OrsoEric/OrangeHat/README.md

# OrangeHat
Raspberry Pi Hat

**TPS55386 Board**  
Dual buck from 2S to 4S LIPO to two 3.0A channels.  
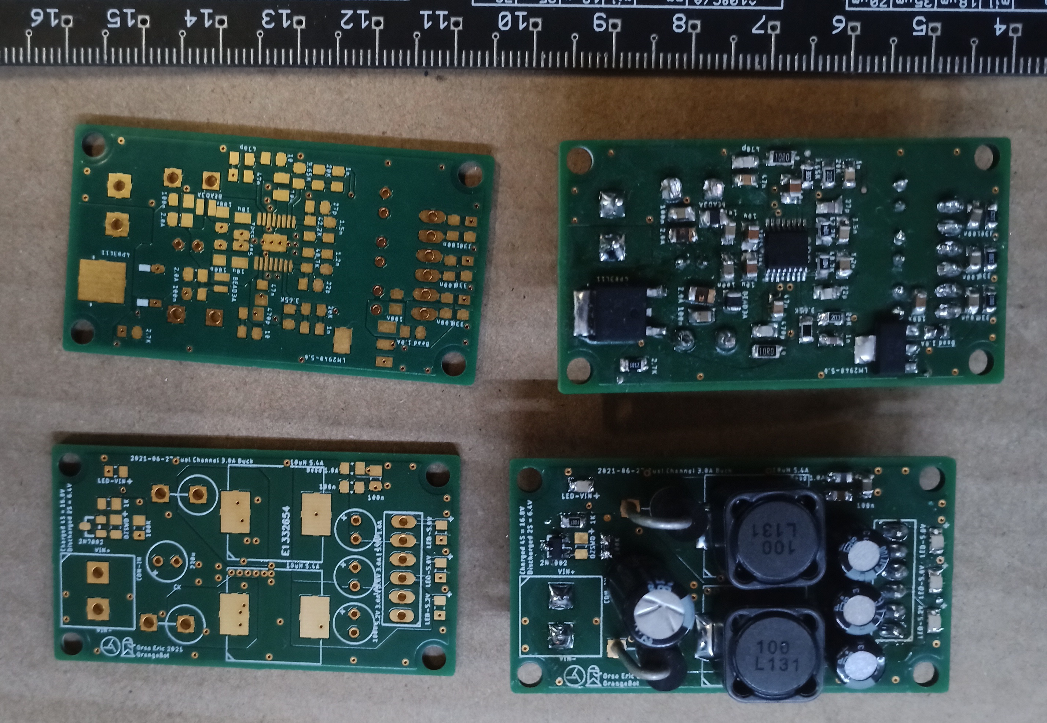
[picture p1: Hardware/Board-Regulator/2021-08-05 TPS55386 Board.jpg]
  

**OrangeHat**  
Assembly
  
  
Demo OrangeHat installed on Maze Runner (click on image to see video on youtube)    
Maze Runner OrangeHat (https://youtu.be/MLvYplDcF7E)  

**OrangeHat Firmware**  
LCD Display (click on image to see video on youtube)  
LCD Display (https://youtu.be/4nYxutRMj2Q)  

Eight Servomotors Demo

https://github.com/user-attachments/assets/cbe1ea65-5b8f-492d-bec4-1e71fcff2395

Eight Servomotor Demo (https://youtu.be/TLqbNKa-QK0)  

**OrangeHat Software**  
NODE.JS Webserver video streaming and serial communication (click on image to see video on youtube)  
NODE.JS (https://youtu.be/cQ1488kovP8)
