OrsoEric/OrangeHat/Software/readme.txt

OrangeHat software running inside the Raspberry Pi
