OrsoEric/OrangeHat/Hardware/Board-Regulator/Readme.md

# Board Regulator Schamatics    
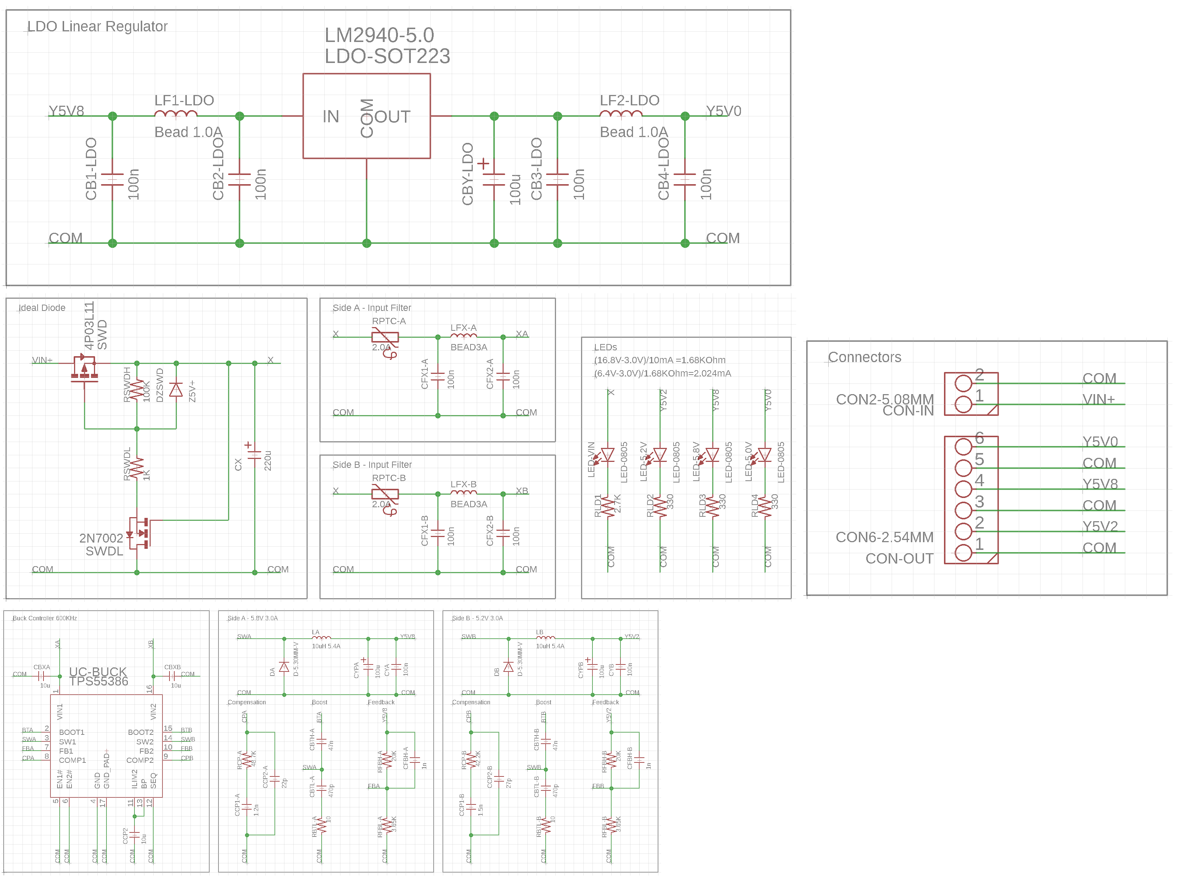
[picture p7: Hardware/Board-Regulator/2021-07-03 Board Voltage Regulator Schematics.PNG]
Board-Regulator
    
  
# Board Regulator PCB  
Output 1: 5.8V 3.0A  
Output 2: 5.2V 3.0A  
Output 3: 5.0V 1.0A  
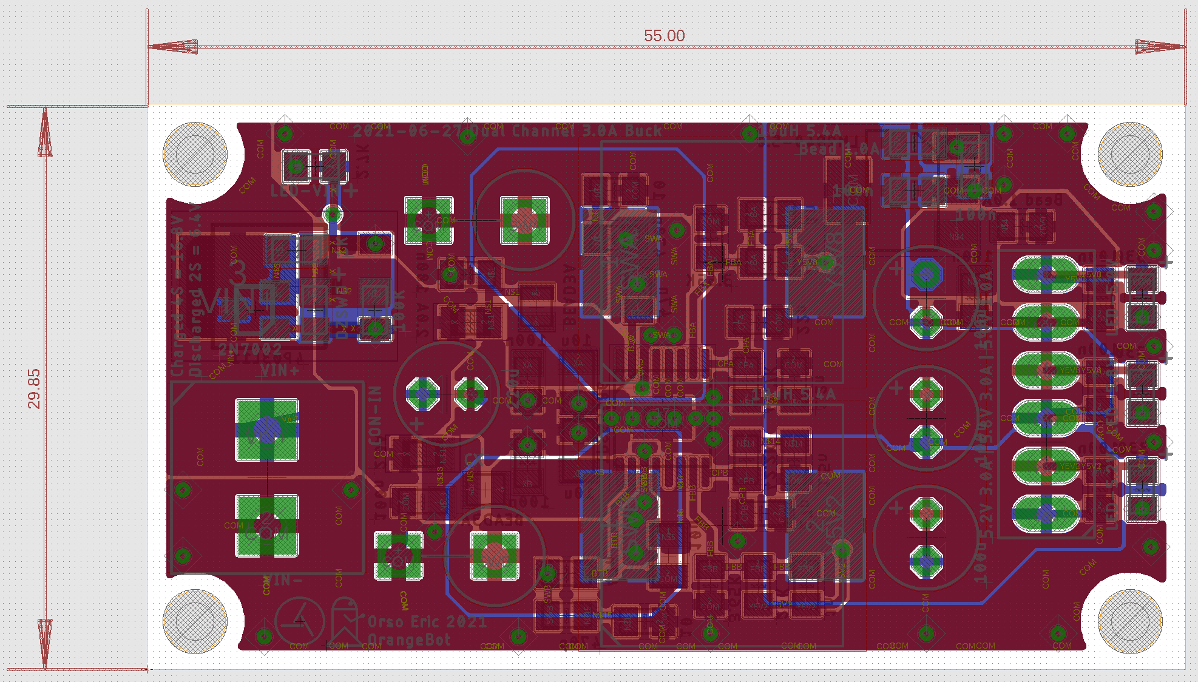
[picture p8: Hardware/2021-07-03 Board Voltage Regulator.PNG]
Board-Regulator
  

Render:
Regulator PCB render:  
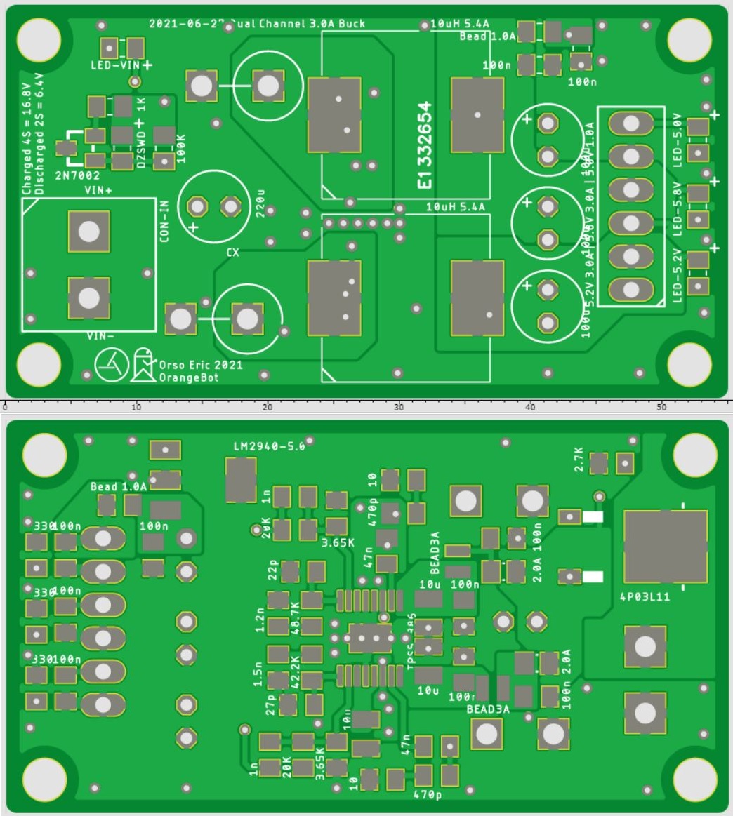
[picture p9: Hardware/Board-Regulator/2021-06-27 Regulator PCB.JPG]
Board PCB Render


**Assembled Board**  
