OrsoEric/OrangeHat/Hardware/OrangeHat/readme.md

**FEATURES**  
- XT60 power connector
- TPS55386 Dual Buck two 5.2V3.0A channels. Reverse voltage protection. Passive and active overcurrent protection.
- Full power monitor. Three voltages, Three currents.
- Raspberry Pi GPIO (10pins) UART and RESET (for bootloader)
- AT4809 microcontroller with UPDI programming
- One user button. Two user LEDs-
- 16x2 LCD screen
- RS485 commuinication over 3.5mm Jack audio cables.
- 8x Servo channels
- Onboard Waveshare 10DOF IMU

**Schematics**  
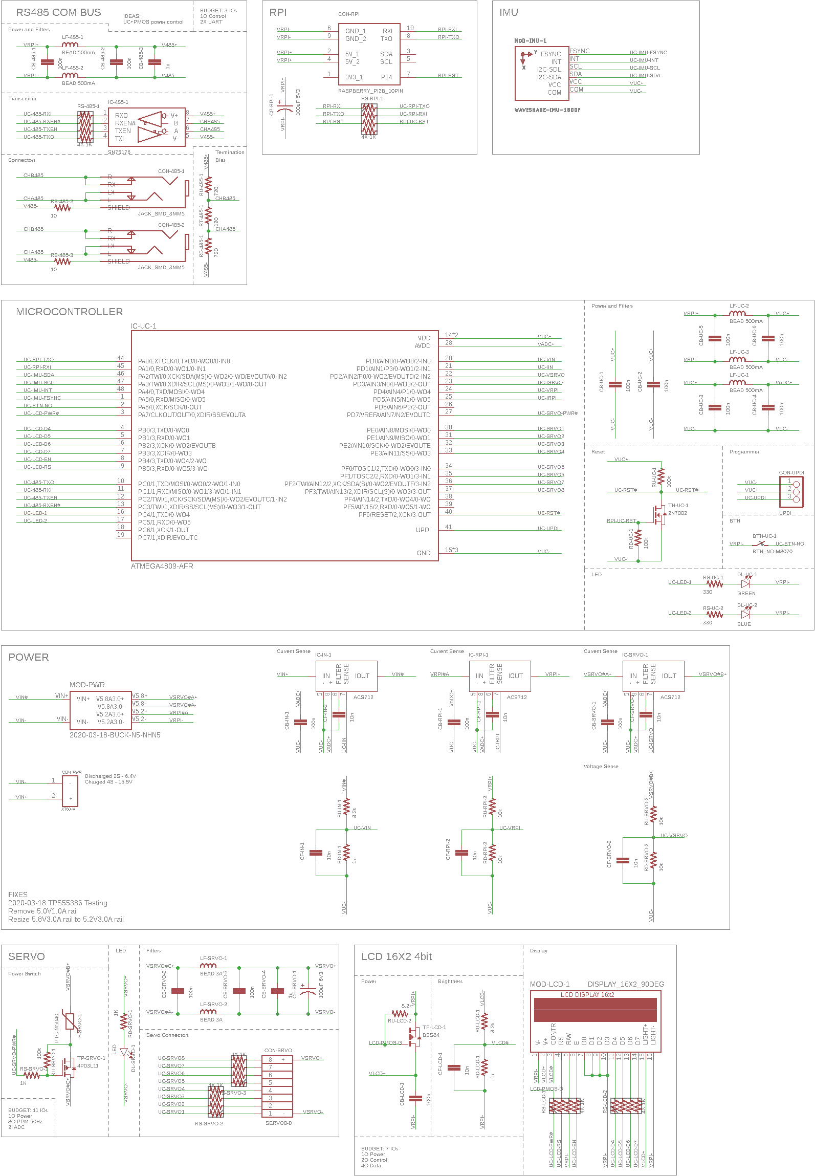
[picture p10: Hardware/OrangeHat/Media/2021-08-11 OrangeHat Schematics.png]
  

**PCB Render**  
Render of PCB, Top and Bot side.  
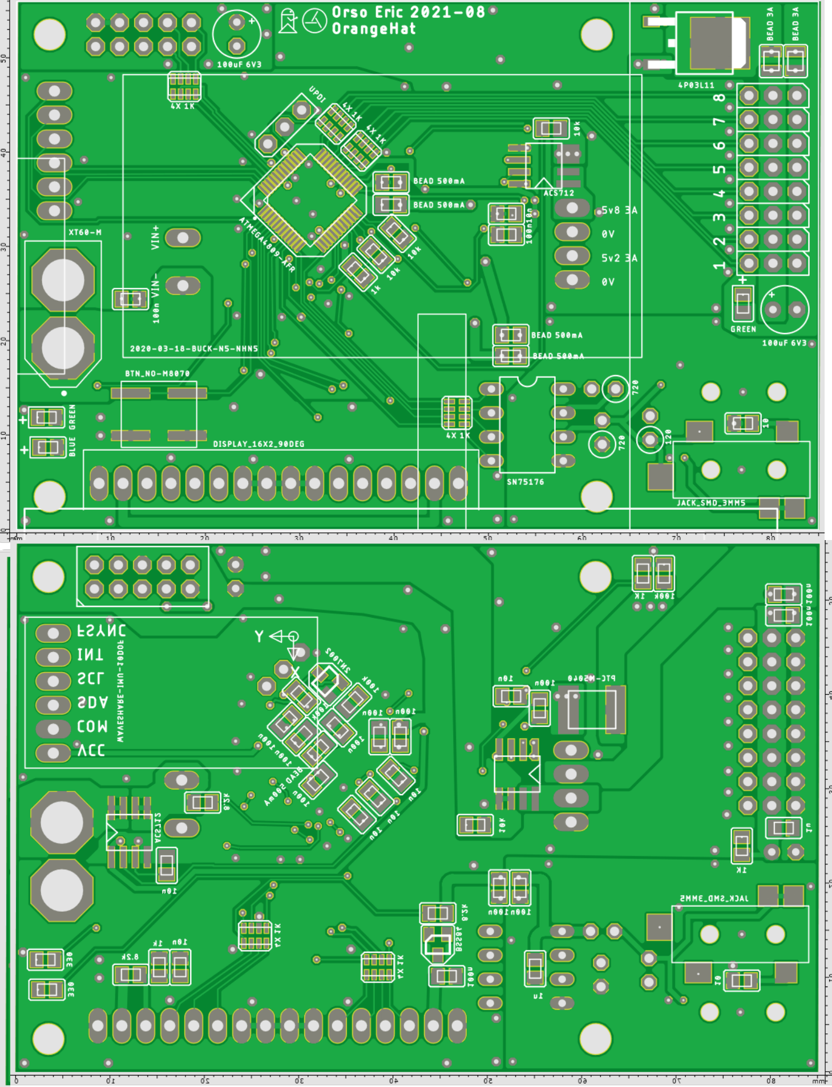
[picture p11: Hardware/OrangeHat/Media/2021-08-11 OrangeHat PCB.PNG]
PCB
  
Render of the gerbers files.  
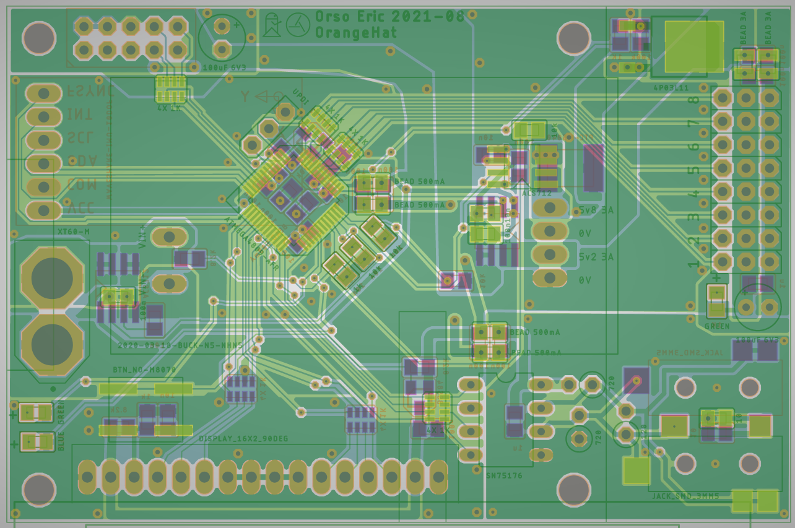
[picture p12: Hardware/OrangeHat/Media/2021-08-11 OrangeHat Gerber.png]
Gerber
  

**Microcontroller Pin Assignment Table**  
