OrsoEric/OrangeHat/Hardware/OrangeHat/Media/2021-07-24 OrangeHat RS485.PNG

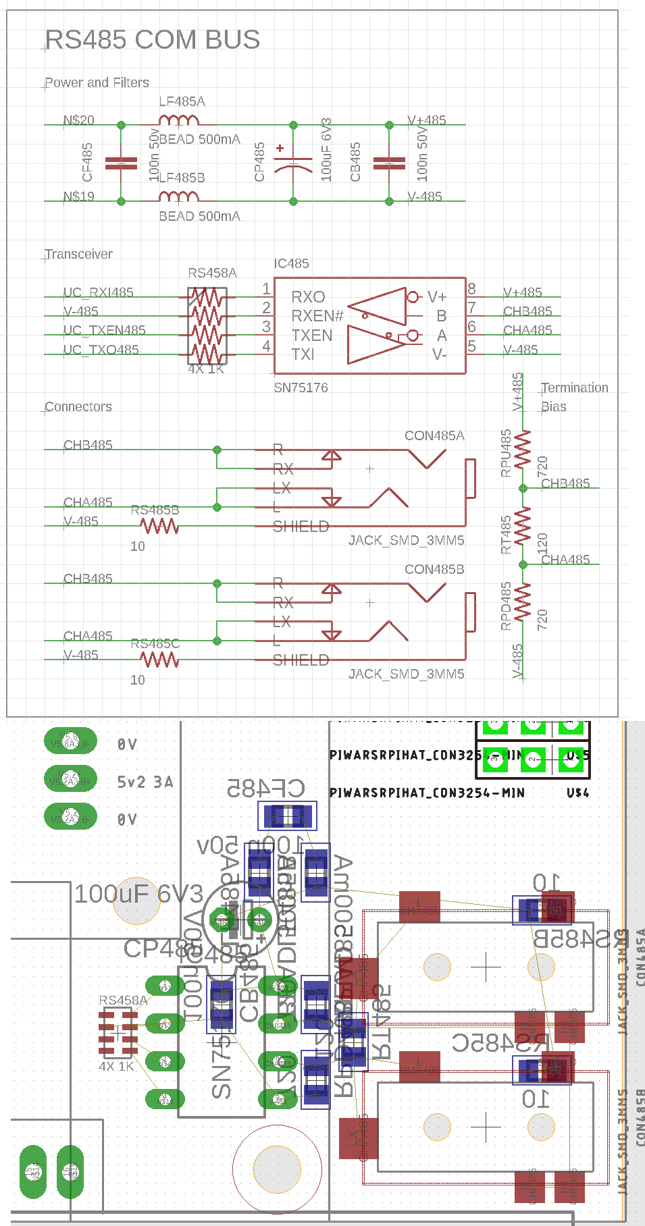
Hardware/OrangeHat/Media/2021-07-24 OrangeHat RS485.PNG
