OrsoEric/OrangeHat/Hardware/OrangeHat/Media/2021-07-25 LCD Placement.PNG

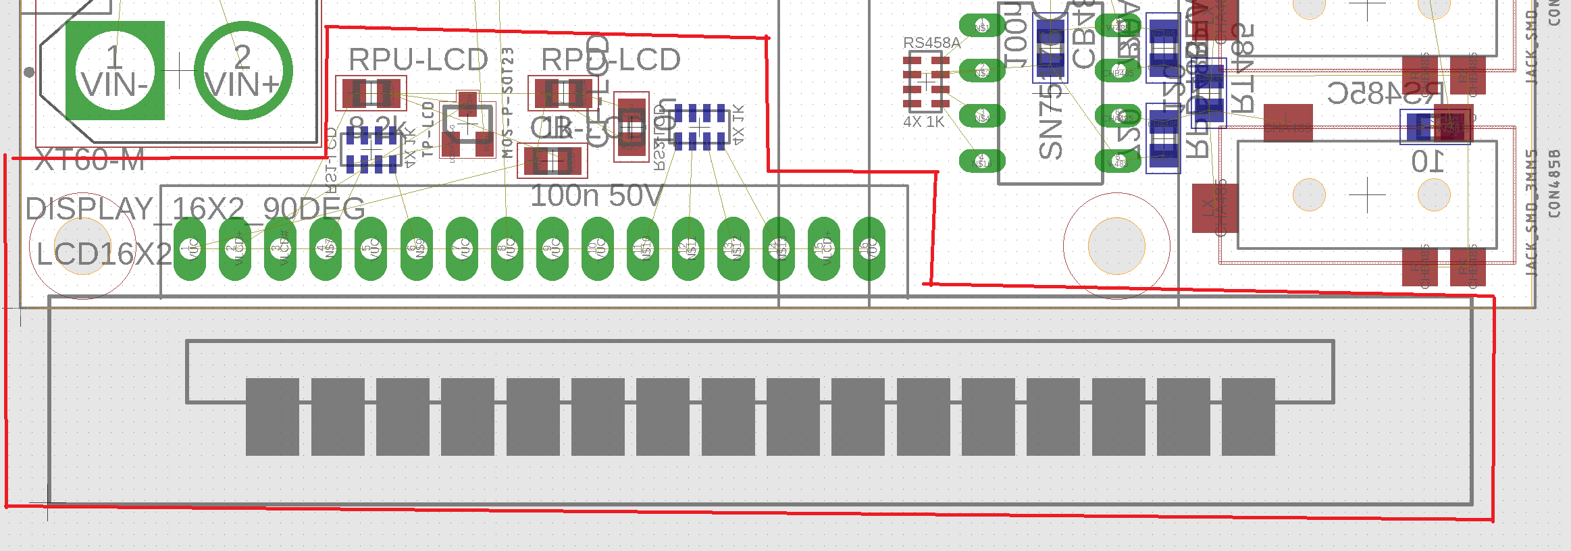
Hardware/OrangeHat/Media/2021-07-25 LCD Placement.PNG
