OrsoEric/OrangeHat/Hardware/OrangeHat/Media/2021-07-25 LCD Schematics.PNG

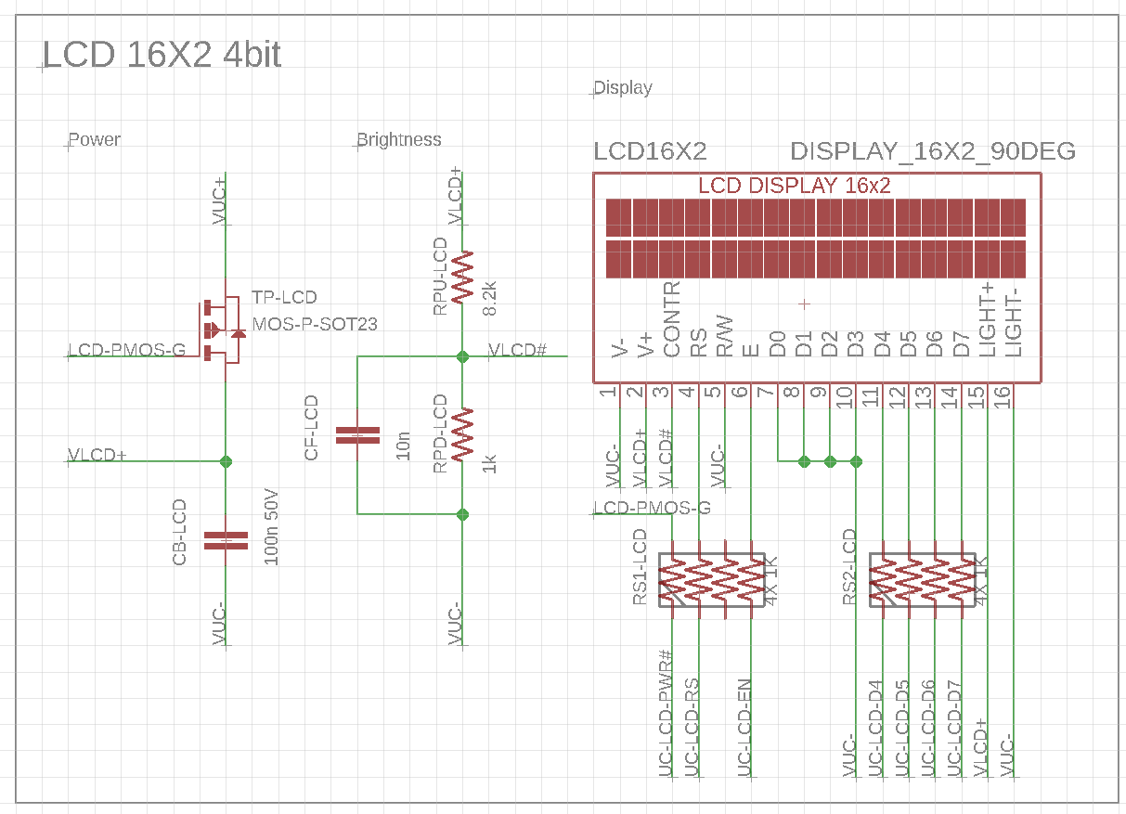
Hardware/OrangeHat/Media/2021-07-25 LCD Schematics.PNG
