OrsoEric/OrangeHat/Hardware/OrangeHat/Media/2021-07-25 OrangeHat LCD Mockup.jpg

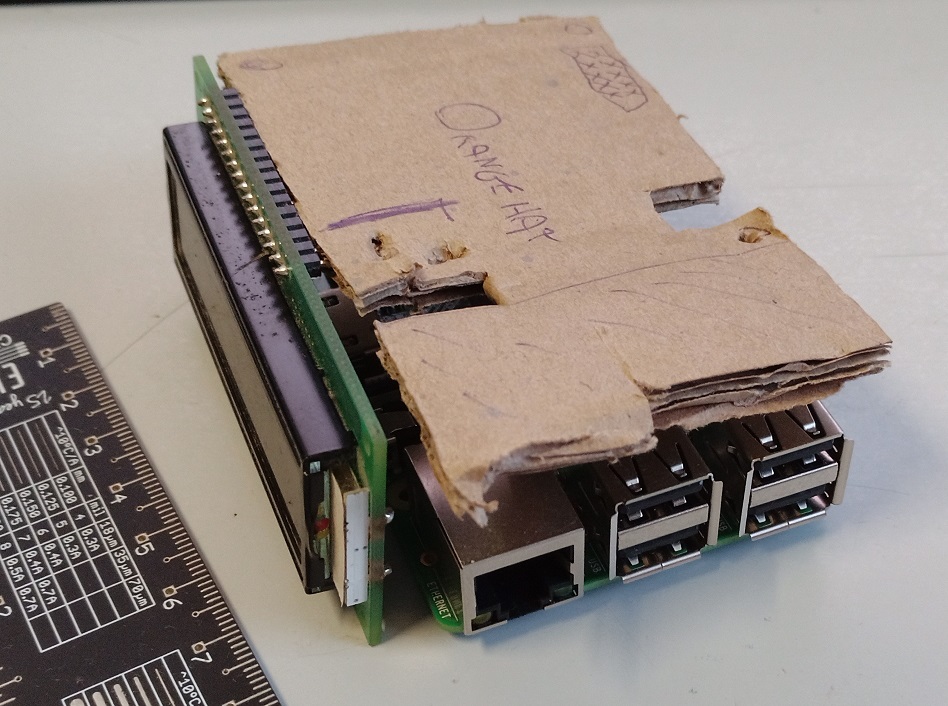
Hardware/OrangeHat/Media/2021-07-25 OrangeHat LCD Mockup.jpg
