OrsoEric/OrangeHat/Hardware/OrangeHat/Media/2021-07-25b OrangeHat Servo Placement.PNG

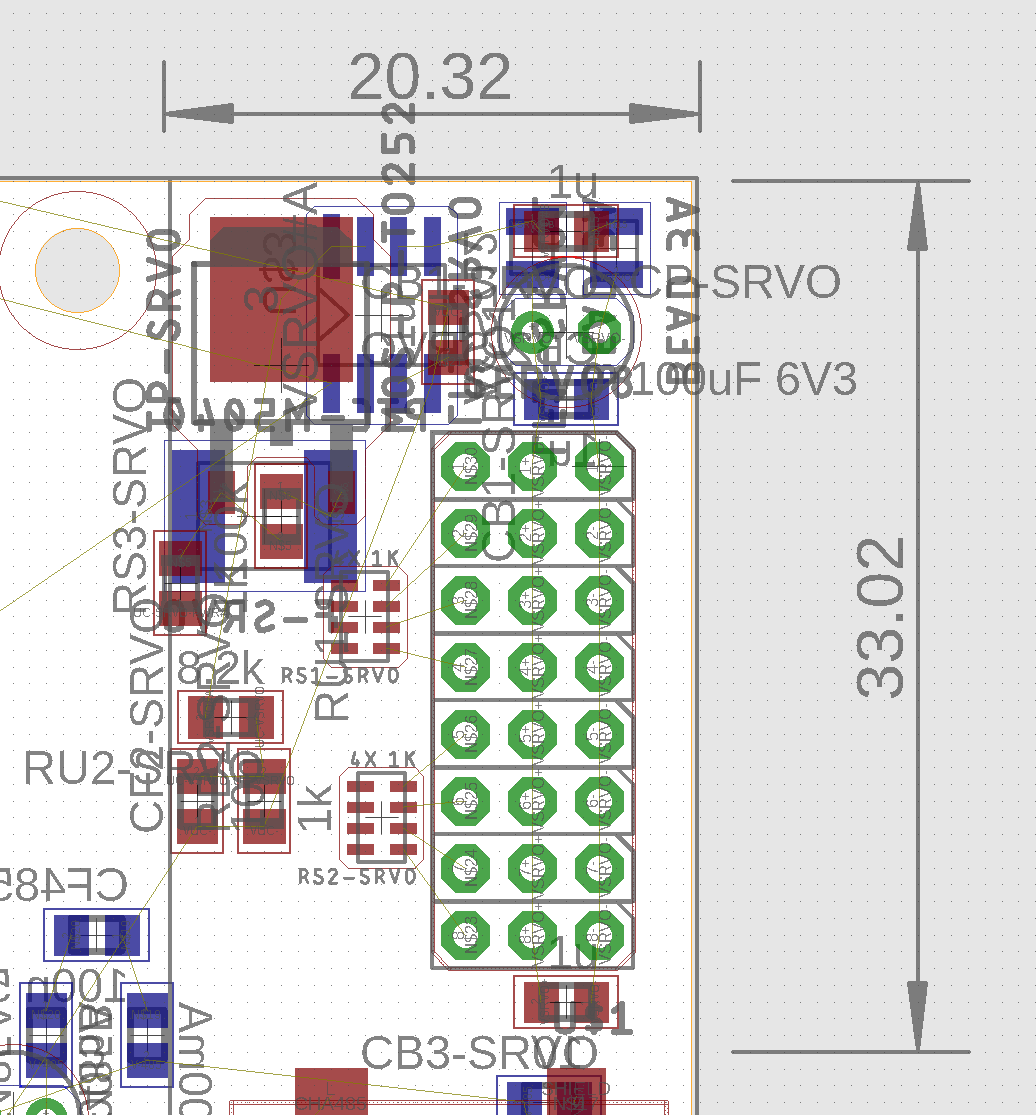
Hardware/OrangeHat/Media/2021-07-25b OrangeHat Servo Placement.PNG
