OrsoEric/OrangeHat/Hardware/OrangeHat/Media/2021-07-25b OrangeHat Servo Schematics.PNG

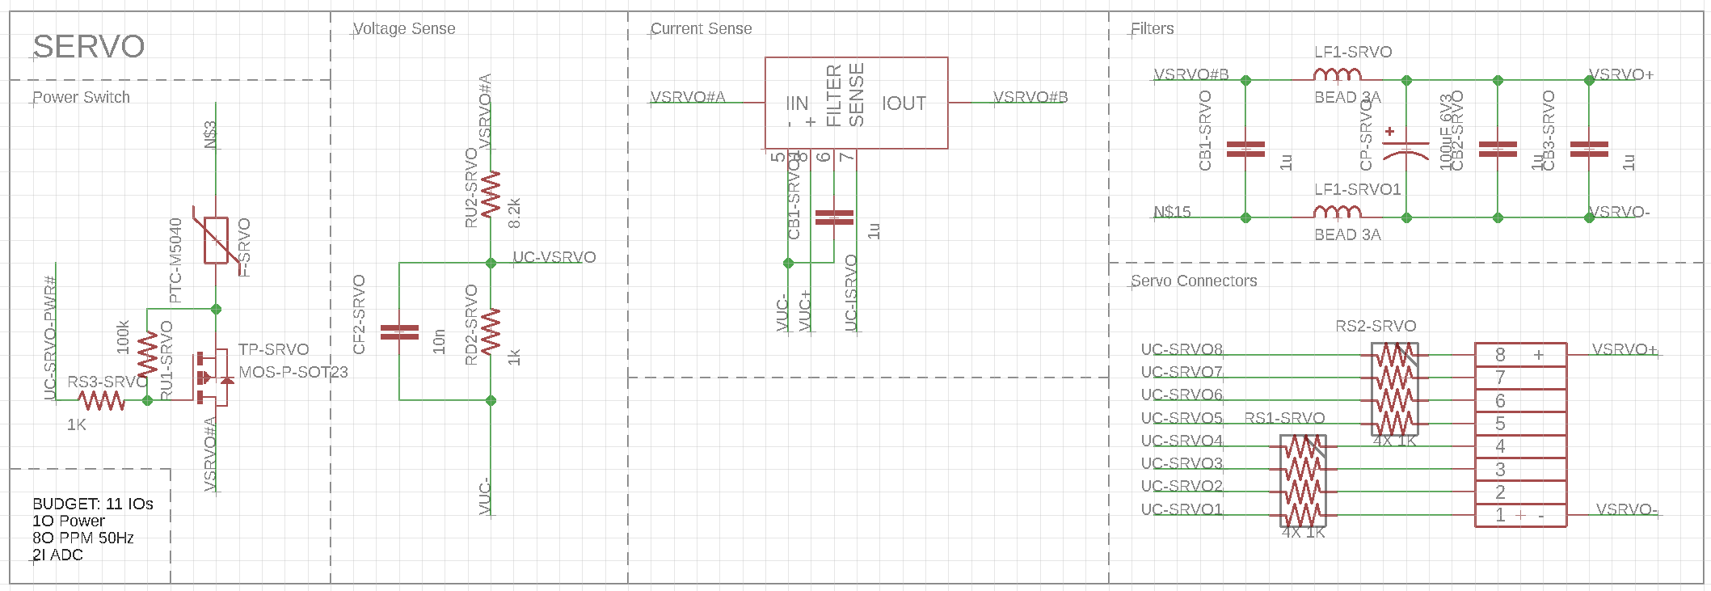
Hardware/OrangeHat/Media/2021-07-25b OrangeHat Servo Schematics.PNG
