OrsoEric/OrangeHat/Hardware/OrangeHat/Media/2021-08-10c autoroute success.PNG

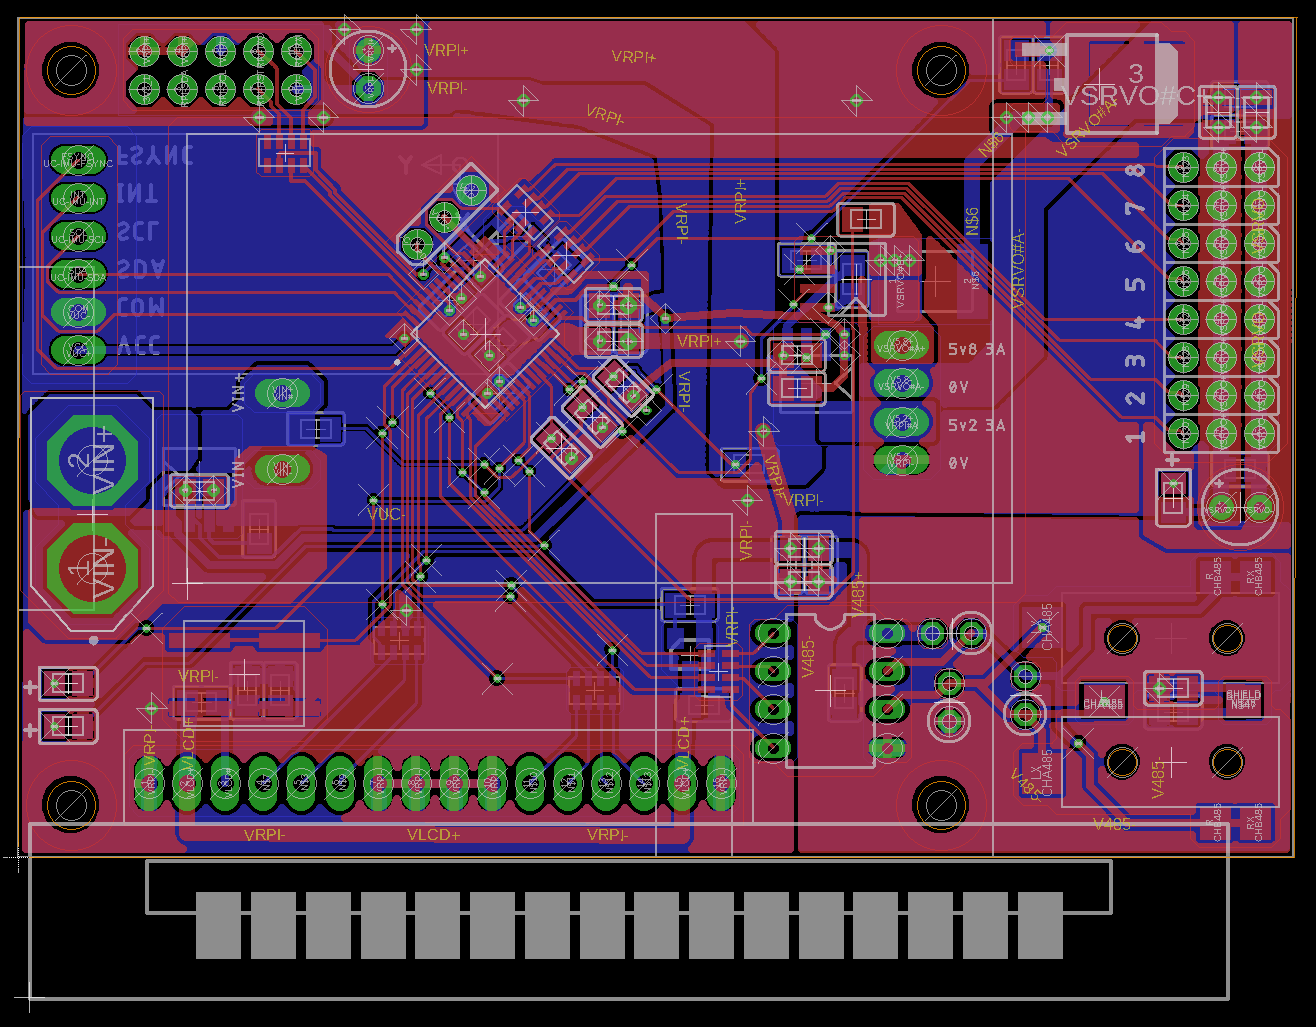
Hardware/OrangeHat/Media/2021-08-10c autoroute success.PNG
