OrsoEric/OrangeHat/Hardware/Board-Regulator/2021-08-05 TPS55386 No Load Test.jpg

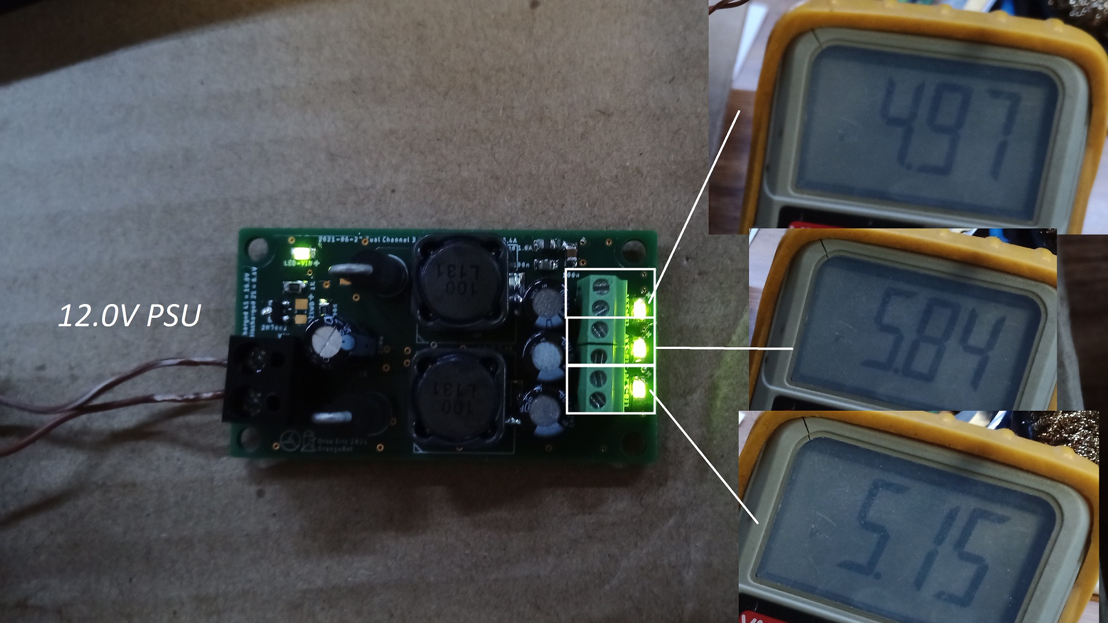
Hardware/Board-Regulator/2021-08-05 TPS55386 No Load Test.jpg
