OrsoEric/OrangeHat/(threads)

Thread 3 (2021-06-27):

OrangeHat Architecture - Microcontroller

OrsoEric, 2021-06-27:
Choose OrangeHat microcontroller
#1 Epic

OrsoEric, 2021-07-04:
Microcontrollers
1. AT4809 8b20MHz
2. GD32VF103 32b108MHz

The Risc-V uC has a good evaluation board with a good screen and is more powerful. The MIPS are needed to run multimotor PIDs. By design decision, this Hat will not integrate the DC H-Bridges, the AT microcontroller is good enough.

Closed 2021-07-04.

Thread 4 (2021-07-03):

Board Regulator

OrsoEric, 2021-07-03:
OrangeBot demonstrated that the dual buck TPS55386 can successfully powewr the raspberry, few servos and the main board.
The regulator is to be moved to its own PCB in a more compact module.
- [x] Schematics
- [x] Routing
- [x] BOM and Order Components
- [x] Print PCBs
- [x] Assembly
- [x] Testing #14
- [ ] Problems 2021-08 #15
- [ ] Schematics V2 to be used inside the OrangeHat

OrsoEric, 2021-07-28:
Regulator PCB render:
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

OrsoEric, 2021-08-05:
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

OrsoEric, 2021-08-08:
Testing revealed some issues that are to be solved in the next hardware release.
Issues don't prevent the regulator tio be used.

The 5.8V channel has nothing wrong by itself, but is not adequate for servo driving.

Closed 2021-12-25.

Thread 5 (2021-07-03):

Board Regulator Schematics and PCB

OrsoEric, 2021-07-03:
Schematics and PCB for the board regulator module.

#4 Board Regulator Epic

OrsoEric, 2021-07-03:
First release of the Board Regulator released.

https://github.com/OrsoEric/OrangeHat/tree/main/Hardware/Board-Regulator

Closed 2021-07-03.

Thread 6 (2021-07-09):

OrangeHat - Architecture Drawing

OrsoEric, 2021-07-09:
#1 Epic OrangeHat Architecture

OrsoEric, 2021-07-31:
Two versions of the OrangeHat are going to be printed.

***OrangeHat - Minimal***

Features Servos and 485 Modbus communication on board. Fixed function to reduce dimensions.  Expandability is through the 485 Modbus 3.5mm Jack connectors.
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

***OrangeHat - MikroBUS***

Features four MikroBUS expansion slots. It allows the communication expansion of choice, 485 Modbus/CAN. It allows for sensors, like IMU, GPS and actuators 5VDC motors, Servos and others. It's the Hat used to prototype adding/removing functionality through clickboards rather than communication bus.
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

Closed 2021-07-31.

Thread 7 (2021-07-24):

Architecture - Choose Communication Bus

OrsoEric, 2021-07-24:
The Raspberry pi Hat is to feature a communication port.
Two main candidates are:

- RS485 BUS (needs a protocol)
- CAN BUS

OrsoEric, 2021-07-24:
Research:

- https://electronics.stackexchange.com/questions/62369/j1708-half-duplex-collision-detection/62380#62380
- https://electronics.stackexchange.com/questions/576059/help-in-deciding-between-rs485-or-can
- https://en.wikibooks.org/wiki/Embedded_Systems/Common_Protocols
- https://electronics.stackexchange.com/questions/335023/protocol-for-rs485-network

OrsoEric, 2021-07-25:
Can bus has a lot of overhead and requires dedicated IC, but has wide adoption in automotive.
No dominant protocol exist for the RS485 bus.
RS485 has been choosen for the slaves. Communication protocol is to be choosen at a later stage of the design.

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

Closed 2021-07-25.

Thread 10 (2021-07-25):

OrangeHat - Schematics - Servo

OrsoEric, 2021-07-25:
Schematics for the Servo section of the board
- 5.8V 3.0A dedicated power line
- Power cut from microcontroller
- 8 servo channels
- Voltage monitoring
- Current Monitoring

OrsoEric, 2021-07-25:
Schematics:
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

Initial placement:
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

Closed 2021-07-25.

Thread 8 (2021-07-25):

OrangeHat - Schematics - Display

OrsoEric, 2021-07-25:
The OrangeHat is to feature a display.
The display is meant to show power and status information.
IDEAS:
- A ROS message may be used to show user messages
- A button can be used to switch between pages (short press) and change parameters (long press)
- Longan Nano is interfaced with a 160x80 RGB OLED
- A 16x8 parallel display can also be used (SELECTED)

OrsoEric, 2021-07-25:
Side mounting the display is very elegant as it leaves the top of the hat free for other hardware.

OrsoEric, 2021-07-25:
The display is side mounted. This solution is elegant as it frees the top of the board and let the display be seen from the side.
The display is meant top show power and status information of the OrangeHat.
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
Schematics. Pin assigment may change to make routing easier.
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
Initial Placement. Gives an idea of possible routing and area use.
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

OrsoEric, 2021-07-25:
Added pullup on TP-LCD gate. Prevent 50Hz issues when microcontroller drive pin is hiz when unprogrammed.

Closed 2021-07-25.

Thread 9 (2021-07-25):

OrangeHat - Schematics

OrsoEric, 2021-07-25:
Design the schematics for the OrangeHat.
Incluides initial placement on PCB to evaluate area and initial pin assignment.

- [x] Microcontroller Pin Assignment #11
- [x] Communication Bus (RS485) #7
- [x] Display #8
- [x] Servo #10
- [x] Power #16

OrsoEric, 2021-08-11:
Final OrangeHat production schematics. Fixed footprints, silkscreen. Checked microcontroller pin assignment. All seems ok, needs testing of physical board.
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

Closed 2021-08-11.

Thread 11 (2021-07-31):

OrangeHat - Microcontroller Pin Assignment

OrsoEric, 2021-07-31:
**OrangeHat**
Plan the pin assignment
- Dual Buck with power sensing
- AT4809 Microcontroller
- RS485 3.5mm Dual Jack communication
- Eight Servo Channels
- Display 16x2
- IMU I2C

OrsoEric, 2021-07-31:
Initial Assignment with initial placement and unrouted lines

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

<BODY TEXT="#000000">
<TABLE FRAME=VOID CELLSPACING=0 COLS=3 RULES=NONE BORDER=0>
	<COLGROUP><COL WIDTH=86><COL WIDTH=86><COL WIDTH=86></COLGROUP>
	<TBODY>
		<TR>
			<TD WIDTH=86 HEIGHT=17 ALIGN=LEFT SDNUM="2057;0;0.000"><B><I>AT4809</I></B></TD>
			<TD WIDTH=86 ALIGN=LEFT SDNUM="2057;0;0.000"><B><I>name</I></B></TD>
			<TD WIDTH=86 ALIGN=LEFT SDNUM="2057;0;0.000"><B><I>assignment</I></B></TD>
		</TR>
		<TR>
			<TD HEIGHT=17 ALIGN=RIGHT SDVAL="44" SDNUM="2057;0;0"><B><I>44</I></B></TD>
			<TD ALIGN=LEFT SDNUM="2057;0;0.000">PA0.txo</TD>
			<TD ALIGN=LEFT SDNUM="2057;0;0.000">rpi.rxi</TD>
		</TR>
		<TR>
			<TD HEIGHT=17 ALIGN=RIGHT SDVAL="45" SDNUM="2057;0;0"><B><I>45</I></B></TD>
			<TD ALIGN=LEFT SDNUM="2057;0;0.000">PA1.rxi</TD>
			<TD ALIGN=LEFT SDNUM="2057;0;0.000">rpi.txo</TD>
		</TR>
		<TR>
			<TD HEIGHT=17 ALIGN=RIGHT SDVAL="46" SDNUM="2057;0;0"><B><I>46</I></B></TD>
			<TD ALIGN=LEFT SDNUM="2057;0;0.000">PA2.sda</TD>
			<TD ALIGN=LEFT SDNUM="2057;0;0.000">imu.sda</TD>
		</TR>
		<TR>
			<TD HEIGHT=17 ALIGN=RIGHT SDVAL="47" SDNUM="2057;0;0"><B><I>47</I></B></TD>
			<TD ALIGN=LEFT SDNUM="2057;0;0.000">PA3.scl</TD>
			<TD ALIGN=LEFT SDNUM="2057;0;0.000">imu.scl</TD>
		</TR>
		<TR>
			<TD HEIGHT=17 ALIGN=RIGHT SDVAL="48" SDNUM="2057;0;0"><B><I>48</I></B></TD>
			<TD ALIGN=LEFT SDNUM="2057;0;0.000">PA4</TD>
			<TD ALIGN=LEFT SDNUM="2057;0;0.000">imu.int</TD>
		</TR>
		<TR>
			<TD HEIGHT=17 ALIGN=RIGHT SDVAL="1" SDNUM="2057;0;0"><B><I>1</I></B></TD>
			<TD ALIGN=LEFT SDNUM="2057;0;0.000">PA5</TD>
			<TD ALIGN=LEFT SDNUM="2057;0;0.000">imu.fsync</TD>
		</TR>
		<TR>
			<TD HEIGHT=17 ALIGN=RIGHT SDVAL="2" SDNUM="2057;0;0"><B><I>2</I></B></TD>
			<TD ALIGN=LEFT SDNUM="2057;0;0.000">PA6</TD>
			<TD ALIGN=LEFT SDNUM="2057;0;0.000"><BR></TD>
		</TR>
		<TR>
			<TD HEIGHT=17 ALIGN=RIGHT SDVAL="3" SDNUM="2057;0;0"><B><I>3</I></B></TD>
			<TD ALIGN=LEFT SDNUM="2057;0;0.000">PA7</TD>
			<TD ALIGN=LEFT SDNUM="2057;0;0.000">display.pwr#</TD>
		</TR>
		<TR>
			<TD HEIGHT=17 ALIGN=RIGHT SDVAL="4" SDNUM="2057;0;0"><B><I>4</I></B></TD>
			<TD ALIGN=LEFT SDNUM="2057;0;0.000">PB0</TD>
			<TD ALIGN=LEFT SDNUM="2057;0;0.000">display.d4</TD>
		</TR>
		<TR>
			<TD HEIGHT=17 ALIGN=RIGHT SDVAL="5" SDNUM="2057;0;0"><B><I>5</I></B></TD>
			<TD ALIGN=LEFT SDNUM="2057;0;0.000">PB1</TD>
			<TD ALIGN=LEFT SDNUM="2057;0;0.000">display.d5</TD>
		</TR>
		<TR>
			<TD HEIGHT=17 ALIGN=RIGHT SDVAL="6" SDNUM="2057;0;0"><B><I>6</I></B></TD>
			<TD ALIGN=LEFT SDNUM="2057;0;0.000">PB2</TD>
			<TD ALIGN=LEFT SDNUM="2057;0;0.000">display.d6</TD>
		</TR>
		<TR>
			<TD HEIGHT=17 ALIGN=RIGHT SDVAL="7" SDNUM="2057;0;0"><B><I>7</I></B></TD>
			<TD ALIGN=LEFT SDNUM="2057;0;0.000">PB3</TD>
			<TD ALIGN=LEFT SDNUM="2057;0;0.000">display.d7</TD>
		</TR>
		<TR>
			<TD HEIGHT=17 ALIGN=RIGHT SDVAL="8" SDNUM="2057;0;0"><B><I>8</I></B></TD>
			<TD ALIGN=LEFT SDNUM="2057;0;0.000">PB4</TD>
			<TD ALIGN=LEFT SDNUM="2057;0;0.000">display.en</TD>
		</TR>
		<TR>
			<TD HEIGHT=17 ALIGN=RIGHT SDVAL="9" SDNUM="2057;0;0"><B><I>9</I></B></TD>
			<TD ALIGN=LEFT SDNUM="2057;0;0.000">PB5</TD>
			<TD ALIGN=LEFT SDNUM="2057;0;0.000">display.rs</TD>
		</TR>
		<TR>
			<TD HEIGHT=17 ALIGN=RIGHT SDVAL="10" SDNUM="2057;0;0"><B><I>10</I></B></TD>
			<TD ALIGN=LEFT SDNUM="2057;0;0.000">PC0.txo</TD>
			<TD ALIGN=LEFT SDNUM="2057;0;0.000">485.rxi</TD>
		</TR>
		<TR>
			<TD HEIGHT=17 ALIGN=RIGHT SDVAL="11" SDNUM="2057;0;0"><B><I>11</I></B></TD>
			<TD ALIGN=LEFT SDNUM="2057;0;0.000">PC1.rxi</TD>
			<TD ALIGN=LEFT SDNUM="2057;0;0.000">485.txo</TD>
		</TR>
		<TR>
			<TD HEIGHT=17 ALIGN=RIGHT SDVAL="12" SDNUM="2057;0;0"><B><I>12</I></B></TD>
			<TD ALIGN=LEFT SDNUM="2057;0;0.000">PC2</TD>
			<TD ALIGN=LEFT SDNUM="2057;0;0.000">485.txen</TD>
		</TR>
		<TR>
			<TD HEIGHT=17 ALIGN=RIGHT SDVAL="13" SDNUM="2057;0;0"><B><I>13</I></B></TD>
			<TD ALIGN=LEFT SDNUM="2057;0;0.000">PC3</TD>
			<TD ALIGN=LEFT SDNUM="2057;0;0.000">485.rxen#</TD>
		</TR>
		<TR>
			<TD HEIGHT=17 ALIGN=RIGHT SDVAL="14" SDNUM="2057;0;0"><B><I>14</I></B></TD>
			<TD ALIGN=LEFT BGCOLOR="#FFFFCC" SDNUM="2057;0;0.000">VDD</TD>
			<TD ALIGN=LEFT SDNUM="2057;0;0.000"><BR></TD>
		</TR>
		<TR>
			<TD HEIGHT=17 ALIGN=RIGHT SDVAL="15" SDNUM="2057;0;0"><B><I>15</I></B></TD>
			<TD ALIGN=LEFT BGCOLOR="#FFFFCC" SDNUM="2057;0;0.000">GND</TD>
			<TD ALIGN=LEFT SDNUM="2057;0;0.000"><BR></TD>
		</TR>
		<TR>
			<TD HEIGHT=17 ALIGN=RIGHT SDVAL="16" SDNUM="2057;0;0"><B><I>16</I></B></TD>
			<TD ALIGN=LEFT SDNUM="2057;0;0.000">PC4</TD>
			<TD ALIGN=LEFT SDNUM="2057;0;0.000"><BR></TD>
		</TR>
		<TR>
			<TD HEIGHT=17 ALIGN=RIGHT SDVAL="17" SDNUM="2057;0;0"><B><I>17</I></B></TD>
			<TD ALIGN=LEFT SDNUM="2057;0;0.000">PC5</TD>
			<TD ALIGN=LEFT SDNUM="2057;0;0.000"><BR></TD>
		</TR>
		<TR>
			<TD HEIGHT=17 ALIGN=RIGHT SDVAL="18" SDNUM="2057;0;0"><B><I>18</I></B></TD>
			<TD ALIGN=LEFT SDNUM="2057;0;0.000">PC6</TD>
			<TD ALIGN=LEFT SDNUM="2057;0;0.000"><BR></TD>
		</TR>
		<TR>
			<TD HEIGHT=17 ALIGN=RIGHT SDVAL="19" SDNUM="2057;0;0"><B><I>19</I></B></TD>
			<TD ALIGN=LEFT SDNUM="2057;0;0.000">PC7</TD>
			<TD ALIGN=LEFT SDNUM="2057;0;0.000"><BR></TD>
		</TR>
		<TR>
			<TD HEIGHT=17 ALIGN=RIGHT SDVAL="20" SDNUM="2057;0;0"><B><I>20</I></B></TD>
			<TD ALIGN=LEFT SDNUM="2057;0;0.000">PD0.ain0</TD>
			<TD ALIGN=LEFT SDNUM="2057;0;0.000">regulator.vin</TD>
		</TR>
		<TR>
			<TD HEIGHT=17 ALIGN=RIGHT SDVAL="21" SDNUM="2057;0;0"><B><I>21</I></B></TD>
			<TD ALIGN=LEFT SDNUM="2057;0;0.000">PD1.ain1</TD>
			<TD ALIGN=LEFT SDNUM="2057;0;0.000">rpi.vsense</TD>
		</TR>
		<TR>
			<TD HEIGHT=17 ALIGN=RIGHT SDVAL="22" SDNUM="2057;0;0"><B><I>22</I></B></TD>
			<TD ALIGN=LEFT SDNUM="2057;0;0.000">PD2.ain2</TD>
			<TD ALIGN=LEFT SDNUM="2057;0;0.000">rpi.isense</TD>
		</TR>
		<TR>
			<TD HEIGHT=17 ALIGN=RIGHT SDVAL="23" SDNUM="2057;0;0"><B><I>23</I></B></TD>
			<TD ALIGN=LEFT SDNUM="2057;0;0.000">PD3.ain3</TD>
			<TD ALIGN=LEFT SDNUM="2057;0;0.000">servo.vsense</TD>
		</TR>
		<TR>
			<TD HEIGHT=17 ALIGN=RIGHT SDVAL="24" SDNUM="2057;0;0"><B><I>24</I></B></TD>
			<TD ALIGN=LEFT SDNUM="2057;0;0.000">PD4.ain4</TD>
			<TD ALIGN=LEFT SDNUM="2057;0;0.000">servo.isense</TD>
		</TR>
		<TR>
			<TD HEIGHT=17 ALIGN=RIGHT SDVAL="25" SDNUM="2057;0;0"><B><I>25</I></B></TD>
			<TD ALIGN=LEFT SDNUM="2057;0;0.000">PD5</TD>
			<TD ALIGN=LEFT SDNUM="2057;0;0.000"><BR></TD>
		</TR>
		<TR>
			<TD HEIGHT=17 ALIGN=RIGHT SDVAL="26" SDNUM="2057;0;0"><B><I>26</I></B></TD>
			<TD ALIGN=LEFT SDNUM="2057;0;0.000">PD6</TD>
			<TD ALIGN=LEFT SDNUM="2057;0;0.000"><BR></TD>
		</TR>
		<TR>
			<TD HEIGHT=17 ALIGN=RIGHT SDVAL="27" SDNUM="2057;0;0"><B><I>27</I></B></TD>
			<TD ALIGN=LEFT SDNUM="2057;0;0.000">PD7</TD>
			<TD ALIGN=LEFT SDNUM="2057;0;0.000">servo.pwr#</TD>
		</TR>
		<TR>
			<TD HEIGHT=17 ALIGN=RIGHT SDVAL="28" SDNUM="2057;0;0"><B><I>28</I></B></TD>
			<TD ALIGN=LEFT BGCOLOR="#FFFFCC" SDNUM="2057;0;0.000">AVDD</TD>
			<TD ALIGN=LEFT SDNUM="2057;0;0.000"><BR></TD>
		</TR>
		<TR>
			<TD HEIGHT=17 ALIGN=RIGHT SDVAL="29" SDNUM="2057;0;0"><B><I>29</I></B></TD>
			<TD ALIGN=LEFT BGCOLOR="#FFFFCC" SDNUM="2057;0;0.000">GND</TD>
			<TD ALIGN=LEFT SDNUM="2057;0;0.000"><BR></TD>
		</TR>
		<TR>
			<TD HEIGHT=17 ALIGN=RIGHT SDVAL="30" SDNUM="2057;0;0"><B><I>30</I></B></TD>
			<TD ALIGN=LEFT SDNUM="2057;0;0.000">PE0</TD>
			<TD ALIGN=LEFT SDNUM="2057;0;0.000">servo.ppm0</TD>
		</TR>
		<TR>
			<TD HEIGHT=17 ALIGN=RIGHT SDVAL="31" SDNUM="2057;0;0"><B><I>31</I></B></TD>
			<TD ALIGN=LEFT SDNUM="2057;0;0.000">PE1</TD>
			<TD ALIGN=LEFT SDNUM="2057;0;0.000">servo.ppm1</TD>
		</TR>
		<TR>
			<TD HEIGHT=17 ALIGN=RIGHT SDVAL="32" SDNUM="2057;0;0"><B><I>32</I></B></TD>
			<TD ALIGN=LEFT SDNUM="2057;0;0.000">PE2</TD>
			<TD ALIGN=LEFT SDNUM="2057;0;0.000">servo.ppm2</TD>
		</TR>
		<TR>
			<TD HEIGHT=17 ALIGN=RIGHT SDVAL="33" SDNUM="2057;0;0"><B><I>33</I></B></TD>
			<TD ALIGN=LEFT SDNUM="2057;0;0.000">PE3</TD>
			<TD ALIGN=LEFT SDNUM="2057;0;0.000">servo.ppm3</TD>
		</TR>
		<TR>
			<TD HEIGHT=17 ALIGN=RIGHT SDVAL="34" SDNUM="2057;0;0"><B><I>34</I></B></TD>
			<TD ALIGN=LEFT SDNUM="2057;0;0.000">PF0</TD>
			<TD ALIGN=LEFT SDNUM="2057;0;0.000">servo.ppm4</TD>
		</TR>
		<TR>
			<TD HEIGHT=17 ALIGN=RIGHT SDVAL="35" SDNUM="2057;0;0"><B><I>35</I></B></TD>
			<TD ALIGN=LEFT SDNUM="2057;0;0.000">PF1</TD>
			<TD ALIGN=LEFT SDNUM="2057;0;0.000">servo.ppm5</TD>
		</TR>
		<TR>
			<TD HEIGHT=17 ALIGN=RIGHT SDVAL="36" SDNUM="2057;0;0"><B><I>36</I></B></TD>
			<TD ALIGN=LEFT SDNUM="2057;0;0.000">PF2</TD>
			<TD ALIGN=LEFT SDNUM="2057;0;0.000">servo.ppm6</TD>
		</TR>
		<TR>
			<TD HEIGHT=17 ALIGN=RIGHT SDVAL="37" SDNUM="2057;0;0"><B><I>37</I></B></TD>
			<TD ALIGN=LEFT SDNUM="2057;0;0.000">PF3</TD>
			<TD ALIGN=LEFT SDNUM="2057;0;0.000">servo.ppm7</TD>
		</TR>
		<TR>
			<TD HEIGHT=17 ALIGN=RIGHT SDVAL="38" SDNUM="2057;0;0"><B><I>38</I></B></TD>
			<TD ALIGN=LEFT SDNUM="2057;0;0.000">PF4</TD>
			<TD ALIGN=LEFT SDNUM="2057;0;0.000"><BR></TD>
		</TR>
		<TR>
			<TD HEIGHT=17 ALIGN=RIGHT SDVAL="39" SDNUM="2057;0;0"><B><I>39</I></B></TD>
			<TD ALIGN=LEFT SDNUM="2057;0;0.000">PF5</TD>
			<TD ALIGN=LEFT SDNUM="2057;0;0.000"><BR></TD>
		</TR>
		<TR>
			<TD HEIGHT=17 ALIGN=RIGHT SDVAL="40" SDNUM="2057;0;0"><B><I>40</I></B></TD>
			<TD ALIGN=LEFT SDNUM="2057;0;0.000">RST#</TD>
			<TD ALIGN=LEFT SDNUM="2057;0;0.000">rpi.gpio7</TD>
		</TR>
		<TR>
			<TD HEIGHT=17 ALIGN=RIGHT SDVAL="41" SDNUM="2057;0;0"><B><I>41</I></B></TD>
			<TD ALIGN=LEFT SDNUM="2057;0;0.000">UPDI</TD>
			<TD ALIGN=LEFT SDNUM="2057;0;0.000"><BR></TD>
		</TR>
		<TR>
			<TD HEIGHT=17 ALIGN=RIGHT SDVAL="42" SDNUM="2057;0;0"><B><I>42</I></B></TD>
			<TD ALIGN=LEFT BGCOLOR="#FFFFCC" SDNUM="2057;0;0.000">VDD</TD>
			<TD ALIGN=LEFT SDNUM="2057;0;0.000"><BR></TD>
		</TR>
		<TR>
			<TD HEIGHT=17 ALIGN=RIGHT SDVAL="43" SDNUM="2057;0;0"><B><I>43</I></B></TD>
			<TD ALIGN=LEFT BGCOLOR="#FFFFCC" SDNUM="2057;0;0.000">GND</TD>
			<TD ALIGN=LEFT SDNUM="2057;0;0.000"><BR></TD>
		</TR>
		<TR>
			<TD HEIGHT=17 ALIGN=LEFT SDNUM="2057;0;0.000"><B><I>RPI GPIO</I></B></TD>
			<TD ALIGN=LEFT SDNUM="2057;0;0.000"><B><I>name</I></B></TD>
			<TD ALIGN=LEFT SDNUM="2057;0;0.000"><B><I>assignment</I></B></TD>
		</TR>
		<TR>
			<TD HEIGHT=17 ALIGN=RIGHT SDVAL="1" SDNUM="2057;0;0.000"><B><I>1.000</I></B></TD>
			<TD ALIGN=LEFT BGCOLOR="#FFFFCC" SDNUM="2057;0;0.000">3V3</TD>
			<TD ALIGN=LEFT SDNUM="2057;0;0.000"><BR></TD>
		</TR>
		<TR>
			<TD HEIGHT=17 ALIGN=RIGHT SDVAL="2" SDNUM="2057;0;0.000"><B><I>2.000</I></B></TD>
			<TD ALIGN=LEFT BGCOLOR="#FFFFCC" SDNUM="2057;0;0.000">5V0</TD>
			<TD ALIGN=LEFT SDNUM="2057;0;0.000"><BR></TD>
		</TR>
		<TR>
			<TD HEIGHT=17 ALIGN=RIGHT SDVAL="3" SDNUM="2057;0;0.000"><B><I>3.000</I></B></TD>
			<TD ALIGN=LEFT SDNUM="2057;0;0.000">GPIO8.SDA</TD>
			<TD ALIGN=LEFT SDNUM="2057;0;0.000"><BR></TD>
		</TR>
		<TR>
			<TD HEIGHT=17 ALIGN=RIGHT SDVAL="4" SDNUM="2057;0;0.000"><B><I>4.000</I></B></TD>
			<TD ALIGN=LEFT BGCOLOR="#FFFFCC" SDNUM="2057;0;0.000">5V0</TD>
			<TD ALIGN=LEFT SDNUM="2057;0;0.000"><BR></TD>
		</TR>
		<TR>
			<TD HEIGHT=17 ALIGN=RIGHT SDVAL="5" SDNUM="2057;0;0.000"><B><I>5.000</I></B></TD>
			<TD ALIGN=LEFT SDNUM="2057;0;0.000">GPIO9.SCL</TD>
			<TD ALIGN=LEFT SDNUM="2057;0;0.000"><BR></TD>
		</TR>
		<TR>
			<TD HEIGHT=17 ALIGN=RIGHT SDVAL="6" SDNUM="2057;0;0.000"><B><I>6.000</I></B></TD>
			<TD ALIGN=LEFT BGCOLOR="#FFFFCC" SDNUM="2057;0;0.000">GND</TD>
			<TD ALIGN=LEFT SDNUM="2057;0;0.000"><BR></TD>
		</TR>
		<TR>
			<TD HEIGHT=17 ALIGN=RIGHT SDVAL="7" SDNUM="2057;0;0.000"><B><I>7.000</I></B></TD>
			<TD ALIGN=LEFT SDNUM="2057;0;0.000">GPIO7</TD>
			<TD ALIGN=LEFT SDNUM="2057;0;0.000">RST#</TD>
		</TR>
		<TR>
			<TD HEIGHT=17 ALIGN=RIGHT SDVAL="8" SDNUM="2057;0;0.000"><B><I>8.000</I></B></TD>
			<TD ALIGN=LEFT SDNUM="2057;0;0.000">GPIO15.txo</TD>
			<TD ALIGN=LEFT SDNUM="2057;0;0.000">PA1.rxi</TD>
		</TR>
		<TR>
			<TD HEIGHT=17 ALIGN=RIGHT SDVAL="9" SDNUM="2057;0;0.000"><B><I>9.000</I></B></TD>
			<TD ALIGN=LEFT BGCOLOR="#FFFFCC" SDNUM="2057;0;0.000">GND</TD>
			<TD ALIGN=LEFT SDNUM="2057;0;0.000"><BR></TD>
		</TR>
		<TR>
			<TD HEIGHT=17 ALIGN=RIGHT SDVAL="10" SDNUM="2057;0;0.000"><B><I>10.000</I></B></TD>
			<TD ALIGN=LEFT SDNUM="2057;0;0.000">GPIO16.rxi</TD>
			<TD ALIGN=LEFT SDNUM="2057;0;0.000">PA0.txo</TD>
		</TR>
	</TBODY>
</TABLE>
</BODY>

</HTML>

OrsoEric, 2021-08-01:
Microcontroller AT4809, power planes, reset circuitry, RPI commuinication.
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

OrsoEric, 2021-08-11:
There was some free pins. Added a button and two LEDs to the microcontroller.

<HTML>
<HEAD>

	<META HTTP-EQUIV="CONTENT-TYPE" CONTENT="text/html; charset=utf-8">
	<TITLE></TITLE>
	<META NAME="GENERATOR" CONTENT="OpenOffice 4.0.1  (Win32)">
	<STYLE>
		<!--
		BODY,DIV,TABLE,THEAD,TBODY,TFOOT,TR,TH,TD,P { font-family:"Arial"; font-size:x-small }
		 -->
	</STYLE>

</HEAD>

<BODY TEXT="#000000">
<TABLE FRAME=VOID CELLSPACING=0 COLS=3 RULES=NONE BORDER=0>
	<COLGROUP><COL WIDTH=86><COL WIDTH=86><COL WIDTH=86></COLGROUP>
	<TBODY>
		<TR>
			<TD WIDTH=86 HEIGHT=17 ALIGN=LEFT SDNUM="2057;0;0.000"><B><I>AT4809</I></B></TD>
			<TD WIDTH=86 ALIGN=LEFT SDNUM="2057;0;0.000"><B><I>name</I></B></TD>
			<TD WIDTH=86 ALIGN=LEFT SDNUM="2057;0;0.000"><B><I>assignment</I></B></TD>
		</TR>
		<TR>
			<TD HEIGHT=17 ALIGN=RIGHT SDVAL="44" SDNUM="2057;0;0"><B><I>44</I></B></TD>
			<TD ALIGN=LEFT SDNUM="2057;0;0.000">PA0.txo</TD>
			<TD ALIGN=LEFT SDNUM="2057;0;0.000">rpi.rxi</TD>
		</TR>
		<TR>
			<TD HEIGHT=17 ALIGN=RIGHT SDVAL="45" SDNUM="2057;0;0"><B><I>45</I></B></TD>
			<TD ALIGN=LEFT SDNUM="2057;0;0.000">PA1.rxi</TD>
			<TD ALIGN=LEFT SDNUM="2057;0;0.000">rpi.txo</TD>
		</TR>
		<TR>
			<TD HEIGHT=17 ALIGN=RIGHT SDVAL="46" SDNUM="2057;0;0"><B><I>46</I></B></TD>
			<TD ALIGN=LEFT SDNUM="2057;0;0.000">PA2.sda</TD>
			<TD ALIGN=LEFT SDNUM="2057;0;0.000">imu.sda</TD>
		</TR>
		<TR>
			<TD HEIGHT=17 ALIGN=RIGHT SDVAL="47" SDNUM="2057;0;0"><B><I>47</I></B></TD>
			<TD ALIGN=LEFT SDNUM="2057;0;0.000">PA3.scl</TD>
			<TD ALIGN=LEFT SDNUM="2057;0;0.000">imu.scl</TD>
		</TR>
		<TR>
			<TD HEIGHT=17 ALIGN=RIGHT SDVAL="48" SDNUM="2057;0;0"><B><I>48</I></B></TD>
			<TD ALIGN=LEFT SDNUM="2057;0;0.000">PA4</TD>
			<TD ALIGN=LEFT SDNUM="2057;0;0.000">imu.int</TD>
		</TR>
		<TR>
			<TD HEIGHT=17 ALIGN=RIGHT SDVAL="1" SDNUM="2057;0;0"><B><I>1</I></B></TD>
			<TD ALIGN=LEFT SDNUM="2057;0;0.000">PA5</TD>
			<TD ALIGN=LEFT SDNUM="2057;0;0.000">imu.fsync</TD>
		</TR>
		<TR>
			<TD HEIGHT=17 ALIGN=RIGHT SDVAL="2" SDNUM="2057;0;0"><B><I>2</I></B></TD>
			<TD ALIGN=LEFT SDNUM="2057;0;0.000">PA6</TD>
			<TD ALIGN=LEFT SDNUM="2057;0;0.000">uc.btn_no</TD>
		</TR>
		<TR>
			<TD HEIGHT=17 ALIGN=RIGHT SDVAL="3" SDNUM="2057;0;0"><B><I>3</I></B></TD>
			<TD ALIGN=LEFT SDNUM="2057;0;0.000">PA7</TD>
			<TD ALIGN=LEFT SDNUM="2057;0;0.000">display.pwr#</TD>
		</TR>
		<TR>
			<TD HEIGHT=17 ALIGN=RIGHT SDVAL="4" SDNUM="2057;0;0"><B><I>4</I></B></TD>
			<TD ALIGN=LEFT SDNUM="2057;0;0.000">PB0</TD>
			<TD ALIGN=LEFT SDNUM="2057;0;0.000">display.d4</TD>
		</TR>
		<TR>
			<TD HEIGHT=17 ALIGN=RIGHT SDVAL="5" SDNUM="2057;0;0"><B><I>5</I></B></TD>
			<TD ALIGN=LEFT SDNUM="2057;0;0.000">PB1</TD>
			<TD ALIGN=LEFT SDNUM="2057;0;0.000">display.d5</TD>
		</TR>
		<TR>
			<TD HEIGHT=17 ALIGN=RIGHT SDVAL="6" SDNUM="2057;0;0"><B><I>6</I></B></TD>
			<TD ALIGN=LEFT SDNUM="2057;0;0.000">PB2</TD>
			<TD ALIGN=LEFT SDNUM="2057;0;0.000">display.d6</TD>
		</TR>
		<TR>
			<TD HEIGHT=17 ALIGN=RIGHT SDVAL="7" SDNUM="2057;0;0"><B><I>7</I></B></TD>
			<TD ALIGN=LEFT SDNUM="2057;0;0.000">PB3</TD>
			<TD ALIGN=LEFT SDNUM="2057;0;0.000">display.d7</TD>
		</TR>
		<TR>
			<TD HEIGHT=17 ALIGN=RIGHT SDVAL="8" SDNUM="2057;0;0"><B><I>8</I></B></TD>
			<TD ALIGN=LEFT SDNUM="2057;0;0.000">PB4</TD>
			<TD ALIGN=LEFT SDNUM="2057;0;0.000">display.en</TD>
		</TR>
		<TR>
			<TD HEIGHT=17 ALIGN=RIGHT SDVAL="9" SDNUM="2057;0;0"><B><I>9</I></B></TD>
			<TD ALIGN=LEFT SDNUM="2057;0;0.000">PB5</TD>
			<TD ALIGN=LEFT SDNUM="2057;0;0.000">display.rs</TD>
		</TR>
		<TR>
			<TD HEIGHT=17 ALIGN=RIGHT SDVAL="10" SDNUM="2057;0;0"><B><I>10</I></B></TD>
			<TD ALIGN=LEFT SDNUM="2057;0;0.000">PC0.txo</TD>
			<TD ALIGN=LEFT SDNUM="2057;0;0.000">485.rxi</TD>
		</TR>
		<TR>
			<TD HEIGHT=17 ALIGN=RIGHT SDVAL="11" SDNUM="2057;0;0"><B><I>11</I></B></TD>
			<TD ALIGN=LEFT SDNUM="2057;0;0.000">PC1.rxi</TD>
			<TD ALIGN=LEFT SDNUM="2057;0;0.000">485.txo</TD>
		</TR>
		<TR>
			<TD HEIGHT=17 ALIGN=RIGHT SDVAL="12" SDNUM="2057;0;0"><B><I>12</I></B></TD>
			<TD ALIGN=LEFT SDNUM="2057;0;0.000">PC2</TD>
			<TD ALIGN=LEFT SDNUM="2057;0;0.000">485.txen</TD>
		</TR>
		<TR>
			<TD HEIGHT=17 ALIGN=RIGHT SDVAL="13" SDNUM="2057;0;0"><B><I>13</I></B></TD>
			<TD ALIGN=LEFT SDNUM="2057;0;0.000">PC3</TD>
			<TD ALIGN=LEFT SDNUM="2057;0;0.000">485.rxen#</TD>
		</TR>
		<TR>
			<TD HEIGHT=17 ALIGN=RIGHT SDVAL="14" SDNUM="2057;0;0"><B><I>14</I></B></TD>
			<TD ALIGN=LEFT BGCOLOR="#FFFFCC" SDNUM="2057;0;0.000">VDD</TD>
			<TD ALIGN=LEFT SDNUM="2057;0;0.000"><BR></TD>
		</TR>
		<TR>
			<TD HEIGHT=17 ALIGN=RIGHT SDVAL="15" SDNUM="2057;0;0"><B><I>15</I></B></TD>
			<TD ALIGN=LEFT BGCOLOR="#FFFFCC" SDNUM="2057;0;0.000">GND</TD>
			<TD ALIGN=LEFT SDNUM="2057;0;0.000"><BR></TD>
		</TR>
		<TR>
			<TD HEIGHT=17 ALIGN=RIGHT SDVAL="16" SDNUM="2057;0;0"><B><I>16</I></B></TD>
			<TD ALIGN=LEFT SDNUM="2057;0;0.000">PC4</TD>
			<TD ALIGN=LEFT SDNUM="2057;0;0.000">uc.led_green</TD>
		</TR>
		<TR>
			<TD HEIGHT=17 ALIGN=RIGHT SDVAL="17" SDNUM="2057;0;0"><B><I>17</I></B></TD>
			<TD ALIGN=LEFT SDNUM="2057;0;0.000">PC5</TD>
			<TD ALIGN=LEFT SDNUM="2057;0;0.000">uc.led_blue</TD>
		</TR>
		<TR>
			<TD HEIGHT=17 ALIGN=RIGHT SDVAL="18" SDNUM="2057;0;0"><B><I>18</I></B></TD>
			<TD ALIGN=LEFT SDNUM="2057;0;0.000">PC6</TD>
			<TD ALIGN=LEFT SDNUM="2057;0;0.000"><BR></TD>
		</TR>
		<TR>
			<TD HEIGHT=17 ALIGN=RIGHT SDVAL="19" SDNUM="2057;0;0"><B><I>19</I></B></TD>
			<TD ALIGN=LEFT SDNUM="2057;0;0.000">PC7</TD>
			<TD ALIGN=LEFT SDNUM="2057;0;0.000"><BR></TD>
		</TR>
		<TR>
			<TD HEIGHT=17 ALIGN=RIGHT SDVAL="20" SDNUM="2057;0;0"><B><I>20</I></B></TD>
			<TD ALIGN=LEFT SDNUM="2057;0;0.000">PD0.ain0</TD>
			<TD ALIGN=LEFT SDNUM="2057;0;0.000">regulator.vin</TD>
		</TR>
		<TR>
			<TD HEIGHT=17 ALIGN=RIGHT SDVAL="21" SDNUM="2057;0;0"><B><I>21</I></B></TD>
			<TD ALIGN=LEFT SDNUM="2057;0;0.000">PD1.ain1</TD>
			<TD ALIGN=LEFT SDNUM="2057;0;0.000">regulator.iin</TD>
		</TR>
		<TR>
			<TD HEIGHT=17 ALIGN=RIGHT SDVAL="22" SDNUM="2057;0;0"><B><I>22</I></B></TD>
			<TD ALIGN=LEFT SDNUM="2057;0;0.000">PD2.ain2</TD>
			<TD ALIGN=LEFT SDNUM="2057;0;0.000">servo.vsense</TD>
		</TR>
		<TR>
			<TD HEIGHT=17 ALIGN=RIGHT SDVAL="23" SDNUM="2057;0;0"><B><I>23</I></B></TD>
			<TD ALIGN=LEFT SDNUM="2057;0;0.000">PD3.ain3</TD>
			<TD ALIGN=LEFT SDNUM="2057;0;0.000">servo.isense</TD>
		</TR>
		<TR>
			<TD HEIGHT=17 ALIGN=RIGHT SDVAL="24" SDNUM="2057;0;0"><B><I>24</I></B></TD>
			<TD ALIGN=LEFT SDNUM="2057;0;0.000">PD4.ain4</TD>
			<TD ALIGN=LEFT SDNUM="2057;0;0.000">rpi.vsense</TD>
		</TR>
		<TR>
			<TD HEIGHT=17 ALIGN=RIGHT SDVAL="25" SDNUM="2057;0;0"><B><I>25</I></B></TD>
			<TD ALIGN=LEFT SDNUM="2057;0;0.000">PD5.ain5</TD>
			<TD ALIGN=LEFT SDNUM="2057;0;0.000">rpi.isense</TD>
		</TR>
		<TR>
			<TD HEIGHT=17 ALIGN=RIGHT SDVAL="26" SDNUM="2057;0;0"><B><I>26</I></B></TD>
			<TD ALIGN=LEFT SDNUM="2057;0;0.000">PD6</TD>
			<TD ALIGN=LEFT SDNUM="2057;0;0.000"><BR></TD>
		</TR>
		<TR>
			<TD HEIGHT=17 ALIGN=RIGHT SDVAL="27" SDNUM="2057;0;0"><B><I>27</I></B></TD>
			<TD ALIGN=LEFT SDNUM="2057;0;0.000">PD7</TD>
			<TD ALIGN=LEFT SDNUM="2057;0;0.000">servo.pwr#</TD>
		</TR>
		<TR>
			<TD HEIGHT=17 ALIGN=RIGHT SDVAL="28" SDNUM="2057;0;0"><B><I>28</I></B></TD>
			<TD ALIGN=LEFT BGCOLOR="#FFFFCC" SDNUM="2057;0;0.000">AVDD</TD>
			<TD ALIGN=LEFT SDNUM="2057;0;0.000"><BR></TD>
		</TR>
		<TR>
			<TD HEIGHT=17 ALIGN=RIGHT SDVAL="29" SDNUM="2057;0;0"><B><I>29</I></B></TD>
			<TD ALIGN=LEFT BGCOLOR="#FFFFCC" SDNUM="2057;0;0.000">GND</TD>
			<TD ALIGN=LEFT SDNUM="2057;0;0.000"><BR></TD>
		</TR>
		<TR>
			<TD HEIGHT=17 ALIGN=RIGHT SDVAL="30" SDNUM="2057;0;0"><B><I>30</I></B></TD>
			<TD ALIGN=LEFT SDNUM="2057;0;0.000">PE0</TD>
			<TD ALIGN=LEFT SDNUM="2057;0;0.000">servo.ppm0</TD>
		</TR>
		<TR>
			<TD HEIGHT=17 ALIGN=RIGHT SDVAL="31" SDNUM="2057;0;0"><B><I>31</I></B></TD>
			<TD ALIGN=LEFT SDNUM="2057;0;0.000">PE1</TD>
			<TD ALIGN=LEFT SDNUM="2057;0;0.000">servo.ppm1</TD>
		</TR>
		<TR>
			<TD HEIGHT=17 ALIGN=RIGHT SDVAL="32" SDNUM="2057;0;0"><B><I>32</I></B></TD>
			<TD ALIGN=LEFT SDNUM="2057;0;0.000">PE2</TD>
			<TD ALIGN=LEFT SDNUM="2057;0;0.000">servo.ppm2</TD>
		</TR>
		<TR>
			<TD HEIGHT=17 ALIGN=RIGHT SDVAL="33" SDNUM="2057;0;0"><B><I>33</I></B></TD>
			<TD ALIGN=LEFT SDNUM="2057;0;0.000">PE3</TD>
			<TD ALIGN=LEFT SDNUM="2057;0;0.000">servo.ppm3</TD>
		</TR>
		<TR>
			<TD HEIGHT=17 ALIGN=RIGHT SDVAL="34" SDNUM="2057;0;0"><B><I>34</I></B></TD>
			<TD ALIGN=LEFT SDNUM="2057;0;0.000">PF0</TD>
			<TD ALIGN=LEFT SDNUM="2057;0;0.000">servo.ppm4</TD>
		</TR>
		<TR>
			<TD HEIGHT=17 ALIGN=RIGHT SDVAL="35" SDNUM="2057;0;0"><B><I>35</I></B></TD>
			<TD ALIGN=LEFT SDNUM="2057;0;0.000">PF1</TD>
			<TD ALIGN=LEFT SDNUM="2057;0;0.000">servo.ppm5</TD>
		</TR>
		<TR>
			<TD HEIGHT=17 ALIGN=RIGHT SDVAL="36" SDNUM="2057;0;0"><B><I>36</I></B></TD>
			<TD ALIGN=LEFT SDNUM="2057;0;0.000">PF2</TD>
			<TD ALIGN=LEFT SDNUM="2057;0;0.000">servo.ppm6</TD>
		</TR>
		<TR>
			<TD HEIGHT=17 ALIGN=RIGHT SDVAL="37" SDNUM="2057;0;0"><B><I>37</I></B></TD>
			<TD ALIGN=LEFT SDNUM="2057;0;0.000">PF3</TD>
			<TD ALIGN=LEFT SDNUM="2057;0;0.000">servo.ppm7</TD>
		</TR>
		<TR>
			<TD HEIGHT=17 ALIGN=RIGHT SDVAL="38" SDNUM="2057;0;0"><B><I>38</I></B></TD>
			<TD ALIGN=LEFT SDNUM="2057;0;0.000">PF4</TD>
			<TD ALIGN=LEFT SDNUM="2057;0;0.000"><BR></TD>
		</TR>
		<TR>
			<TD HEIGHT=17 ALIGN=RIGHT SDVAL="39" SDNUM="2057;0;0"><B><I>39</I></B></TD>
			<TD ALIGN=LEFT SDNUM="2057;0;0.000">PF5</TD>
			<TD ALIGN=LEFT SDNUM="2057;0;0.000"><BR></TD>
		</TR>
		<TR>
			<TD HEIGHT=17 ALIGN=RIGHT SDVAL="40" SDNUM="2057;0;0"><B><I>40</I></B></TD>
			<TD ALIGN=LEFT SDNUM="2057;0;0.000">RST#</TD>
			<TD ALIGN=LEFT SDNUM="2057;0;0.000">rpi.gpio7</TD>
		</TR>
		<TR>
			<TD HEIGHT=17 ALIGN=RIGHT SDVAL="41" SDNUM="2057;0;0"><B><I>41</I></B></TD>
			<TD ALIGN=LEFT SDNUM="2057;0;0.000">UPDI</TD>
			<TD ALIGN=LEFT SDNUM="2057;0;0.000"><BR></TD>
		</TR>
		<TR>
			<TD HEIGHT=17 ALIGN=RIGHT SDVAL="42" SDNUM="2057;0;0"><B><I>42</I></B></TD>
			<TD ALIGN=LEFT BGCOLOR="#FFFFCC" SDNUM="2057;0;0.000">VDD</TD>
			<TD ALIGN=LEFT SDNUM="2057;0;0.000"><BR></TD>
		</TR>
		<TR>
			<TD HEIGHT=17 ALIGN=RIGHT SDVAL="43" SDNUM="2057;0;0"><B><I>43</I></B></TD>
			<TD ALIGN=LEFT BGCOLOR="#FFFFCC" SDNUM="2057;0;0.000">GND</TD>
			<TD ALIGN=LEFT SDNUM="2057;0;0.000"><BR></TD>
		</TR>
		<TR>
			<TD HEIGHT=17 ALIGN=LEFT SDNUM="2057;0;0.000"><B><I>RPI GPIO</I></B></TD>
			<TD ALIGN=LEFT SDNUM="2057;0;0.000"><B><I>name</I></B></TD>
			<TD ALIGN=LEFT SDNUM="2057;0;0.000"><B><I>assignment</I></B></TD>
		</TR>
		<TR>
			<TD HEIGHT=17 ALIGN=RIGHT SDVAL="1" SDNUM="2057;0;0.000"><B><I>1.000</I></B></TD>
			<TD ALIGN=LEFT BGCOLOR="#FFFFCC" SDNUM="2057;0;0.000">3V3</TD>
			<TD ALIGN=LEFT SDNUM="2057;0;0.000"><BR></TD>
		</TR>
		<TR>
			<TD HEIGHT=17 ALIGN=RIGHT SDVAL="2" SDNUM="2057;0;0.000"><B><I>2.000</I></B></TD>
			<TD ALIGN=LEFT BGCOLOR="#FFFFCC" SDNUM="2057;0;0.000">5V0</TD>
			<TD ALIGN=LEFT SDNUM="2057;0;0.000"><BR></TD>
		</TR>
		<TR>
			<TD HEIGHT=17 ALIGN=RIGHT SDVAL="3" SDNUM="2057;0;0.000"><B><I>3.000</I></B></TD>
			<TD ALIGN=LEFT SDNUM="2057;0;0.000">GPIO8.SDA</TD>
			<TD ALIGN=LEFT SDNUM="2057;0;0.000"><BR></TD>
		</TR>
		<TR>
			<TD HEIGHT=17 ALIGN=RIGHT SDVAL="4" SDNUM="2057;0;0.000"><B><I>4.000</I></B></TD>
			<TD ALIGN=LEFT BGCOLOR="#FFFFCC" SDNUM="2057;0;0.000">5V0</TD>
			<TD ALIGN=LEFT SDNUM="2057;0;0.000"><BR></TD>
		</TR>
		<TR>
			<TD HEIGHT=17 ALIGN=RIGHT SDVAL="5" SDNUM="2057;0;0.000"><B><I>5.000</I></B></TD>
			<TD ALIGN=LEFT SDNUM="2057;0;0.000">GPIO9.SCL</TD>
			<TD ALIGN=LEFT SDNUM="2057;0;0.000"><BR></TD>
		</TR>
		<TR>
			<TD HEIGHT=17 ALIGN=RIGHT SDVAL="6" SDNUM="2057;0;0.000"><B><I>6.000</I></B></TD>
			<TD ALIGN=LEFT BGCOLOR="#FFFFCC" SDNUM="2057;0;0.000">GND</TD>
			<TD ALIGN=LEFT SDNUM="2057;0;0.000"><BR></TD>
		</TR>
		<TR>
			<TD HEIGHT=17 ALIGN=RIGHT SDVAL="7" SDNUM="2057;0;0.000"><B><I>7.000</I></B></TD>
			<TD ALIGN=LEFT SDNUM="2057;0;0.000">GPIO7</TD>
			<TD ALIGN=LEFT SDNUM="2057;0;0.000">RST#</TD>
		</TR>
		<TR>
			<TD HEIGHT=17 ALIGN=RIGHT SDVAL="8" SDNUM="2057;0;0.000"><B><I>8.000</I></B></TD>
			<TD ALIGN=LEFT SDNUM="2057;0;0.000">GPIO15.txo</TD>
			<TD ALIGN=LEFT SDNUM="2057;0;0.000">PA1.rxi</TD>
		</TR>
		<TR>
			<TD HEIGHT=17 ALIGN=RIGHT SDVAL="9" SDNUM="2057;0;0.000"><B><I>9.000</I></B></TD>
			<TD ALIGN=LEFT BGCOLOR="#FFFFCC" SDNUM="2057;0;0.000">GND</TD>
			<TD ALIGN=LEFT SDNUM="2057;0;0.000"><BR></TD>
		</TR>
		<TR>
			<TD HEIGHT=17 ALIGN=RIGHT SDVAL="10" SDNUM="2057;0;0.000"><B><I>10.000</I></B></TD>
			<TD ALIGN=LEFT SDNUM="2057;0;0.000">GPIO16.rxi</TD>
			<TD ALIGN=LEFT SDNUM="2057;0;0.000">PA0.txo</TD>
		</TR>
	</TBODY>
</TABLE>
</BODY>

</HTML>

Closed 2021-08-11.

Thread 12 (2021-07-31):

OrangeHat - PCB Routing

OrsoEric, 2021-07-31:
Routing of the OrangeHat PCB

- [x] Design Rules  #13
- [x] Net Classes
- [x] Library, components and footprints
- [x] Placement
- [x] Routing
- [x] DRC

OrsoEric, 2021-08-09:
Full Placement
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

OrsoEric, 2021-08-09:
Net Classes:
- Signal (Smallest trace)
- Supply (Logic IC Power trace)
- Power (Power Traces)

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

OrsoEric, 2021-08-09:
completes initial placement. iterates on routing of power lines.
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

OrsoEric, 2021-08-10:
Complete Autorute:
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

OrsoEric, 2021-08-11:
Completes routing. Various fixes applied.
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

Render of the PCB gerbers. Production Ready.
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

Closed 2021-08-11.

Thread 13 (2021-08-01):

OrangeHat - PCB - Design Rules

OrsoEric, 2021-08-01:
The PCB is going to be manufactured by [Eurocircuit](https://www.eurocircuits.com/)

Technology Class: 6C

Specifications:

- Layers: 2
- Copper Thickness: 35um
- Board Thickness: 1.4mm
- OTW (Track Width): 150um
- OTT OTP OPP (Track Pad Clearance): 150um
- OAR (plated hole copper outer-inner radious): 125um
- PTH (plated through hole diameter): 250um
- NPTH (non plated through hole diameter): 350um
- Max PCB Thickness: 2,4mm

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

Closed 2021-08-01.

Thread 14 (2021-08-05):

Board Regulator TPS55386 Testing

OrsoEric, 2021-08-05:
Test the TPS55386 board.

PASS:
- [x] Test noload
- [x] Test 5.2V 8X Servo Load
- [x] Test 5.2V RPI Load
- [x] Test 5.2V 2.2Ohm/3x10Ohm Load
- [x] Test 5.8V 2.2Ohm/3x10Ohm Load

FAIL
- [x]  Test 5.8V 3X Servo Load

OrsoEric, 2021-08-05:
No Load test with stable VIN

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

OrsoEric, 2021-08-08:
Test 5.2V3.0A channel with 8xServos and Unit Zero AT324 Module and firmware to load the regulator.

VIDEO (Click to view on youtube):
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

OrsoEric, 2021-08-08:
Test 5.2V RPI Load: 50mV voltage ripple

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

OrsoEric, 2021-08-08:
Test 5.2V 2.2Ohm/3x10Ohm Load
Test 5.8V 2.2Ohm/3x10Ohm Load

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

OrsoEric, 2021-08-08:
Testing Complete. The TPS55386 is good enough. There are problems to be solved in the next version.

Closed 2021-08-08.

Thread 15 (2021-08-05):

Board Regulator TPS55386 - Problems

OrsoEric, 2021-08-05:
List of problems identified in the TPS55386 board

OrsoEric, 2021-08-05:
RPTC-A, RPTC-B -> Footprint SMD5040M
LFX-A, LFX-B -> Footprint SMD2117M

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

OrsoEric, 2021-08-08:
Attaching a number of servos to the 5.8V channel causes the TPS55386 to enter in current protection mode.

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

Thread 16 (2021-08-09):

OrangeHat - Schematics - Power

OrsoEric, 2021-08-09:
Power system of the OrangeHat

- [x] Test Module 2020-03-18 TPS55386 Dual Buck 3.0A #14

OrsoEric, 2021-08-09:
Testing with the stand alone TPS55386 module revealed that powering servos at 5.8V causes the TPS55386 to hit the current limit and stall. Both channels stall at the same time, which is bad.

Change the compensation network and output of the module to have two 5.2V3.0A outputs, and remove the LDO stage that generates the 5.01.0A channel from the 5.8V3.0A channel.

Add a filter to make microcontroller power from the 5.2V3.0A RPI power line.

OrsoEric, 2021-08-09:
Schematics of the power system for the OrangeHat

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

OrsoEric, 2021-08-09:
For this version of the OrangeHat I include a full power monitor for:
- VIN, IIN
- VSRVO, ISRVO
- VRPI, RPI

This allows  to monitor efficiency, battery and energy, later revision of the hat may scale down on monitoring or use other components. I use the ACS712 since I have a bunch of them.

Later revisions of the power system can do smarter things with the monitoring, protection and cut off switches.

Closed 2021-08-09.

Thread 17 (2021-08-11):

OrangeHat - Assembly and Testing

OrsoEric, 2021-08-11:
Assemble and test the OrangeHat step by step.

- [ ] Power Delivery
- [ ] Microcontroller
- [ ] Raspberry Pi
- [ ] Servo
- [ ] Display
- [ ] IMU

OrsoEric, 2021-12-25:
Power Delivery
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

OrsoEric, 2021-12-25:
2021-09-18 Programming.
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

OrsoEric, 2021-12-25:
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

OrsoEric, 2022-01-05:
Powering the servo causes brownout #22  #24

OrsoEric, 2022-01-07:
Demo OrangeHat installed on Maze Runner
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

Thread 20 (2021-12-19):

OrangeHat - Firmware - LED Blink

OrsoEric, 2021-12-19:
Test programmer
Build up pin configuration
Make a LED on the board blink

OrsoEric, 2021-12-19:
2021-09-18. LED Blink and programming operational.

Closed 2021-12-19.

Thread 22 (2021-12-19):

OrangeHat - Firmware - Servo

OrsoEric, 2021-12-19:
Port the Servo library written previously for AT324 microcontroller for Unit Zero to the AT4809 for the OrangeHat
- [x] Giving power to the Servo bank causes a brownout on VSRVO.B and VRPI lines due to charge sharing. Regulator recovers within 20ms.
- [x] When position is LOCK and IDLE, driver no longer emits signals.
- [x] Random position and speed demo
- [ ] Microchip Studio doesn't see .hpp
- [ ] Microchip studio C++ compiler doesn't work with class implementation and declaration in same file
- [x] Channel 2 doesn't work
- [x] Continuous rotation servo goes only in one direction
- [ ] Servo channel names should use letters or 0 indexed numbers. It's confusing to have SERVO1 assigned to CHANNEL0 in the array
- [ ] Separate the HAL class from the Servo class, so that it becomes microcontroller independent
- [ ] Finish the error reporting mechanism so that the ISR doesn't executes and IO are IDLE and OFF if something goes wrong
- [ ] Add the operator square bracket overload to conveniently write the position using vector syntax
- [ ] Implements the function reference to call the servo class instance ISR method by the ISR that is not defined inside the class

OrsoEric, 2021-12-19:
PROBLEM: Giving power to the servo banks, causes a brownout.
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

OrsoEric, 2022-01-04:
Servo driver now implements commands and a scalable number of channels. The interface is position in microseconds and speed in microsecond per seconds.
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

OrsoEric, 2022-01-05:
Eight servo channels operational. Image below shows sampling of channel one and channel eight
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

OrsoEric, 2022-01-05:
Channel 2 fix: It was a bad solder joint on the 4X1KOhm resistor bank (FIXED)

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

OrsoEric, 2022-01-05:
Problem with rotation servo is simply due to a skew in the Parallax 50RPM servomotor, that goes faster in one direction.
In the future I need to think about calibration and conversion. I think I'll do a class dedicated to convert from degrees or degrees per second or RPM to microseconds and embed calibration parameters inside that class, so that the driver just takes care of emitting a pure PPM waveform with 1500us zero and 20000us period.

OrsoEric, 2022-01-05:
Servo Driver is operational.
Moving on to advance other drivers to working state before adding bells and whistles to the Servo driver.

Closed 2022-01-05.

Thread 23 (2022-01-05):

OrangeHat - Firmware - RPI UART Communication

OrsoEric, 2022-01-05:
The Raspberry PI communicates with ATMega4809 inside the OrangeHat using a bidirectional UART channel and a RPI controlled Reset.

Implement the communication and parser driver so that the OrangeHat answer to the same messages as OrangeBot allowing the Raspberry Pi hosted NODE.JS webserver application to move the robot using continuous rotation servos attached to the OrangeHat.

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

- [x] Transmits bytes to the RPI RXI pin (checked with oscilloscope)
- [x] Loopback from hat TXO to hat RXI receives bytes (checked with counters)
- [x] Test RaspberryPi communication with a NODE.JS application

OrsoEric, 2022-01-07:
Serial communication with Raspberry Pi
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

OrsoEric, 2022-01-08:
Servo Find and Ping operational. To be expanded in the future.

Closed 2022-01-08.

Thread 24 (2022-01-05):

Board OrangeHat - Problems

OrsoEric, 2022-01-05:
- [ ] Servo Brownout #22

Thread 27 (2022-01-09):

OrangeHat - Firmware - ADC

OrsoEric, 2022-01-09:
OrangeHat features a voltage and current channel for input, servo and raspberry pi power.

OrangeHat firmware is meant to keep those values updated, and allow the Raspberry Pi to get information on current, voltages, power, uptime and overall energy used by each of those components.

Eventually this is to be integrated with the battery management to predict battery health and battery remaining.

OrsoEric, 2022-01-09:
Implements initial ADC driver that samples raw temperature reading.

111 to 112 @10b with AVDD voltage reference.
TODO: Move to 4.2 internal voltage reference
TODO: Scan six external channel, and interal temperature channel.
