OrsoEric/OrangeHat/Hardware/OrangeHat/2021-07-02 OrangeHat.brd

## EAGLE design Hardware/OrangeHat/2021-07-02 OrangeHat.brd (2021-08-11)

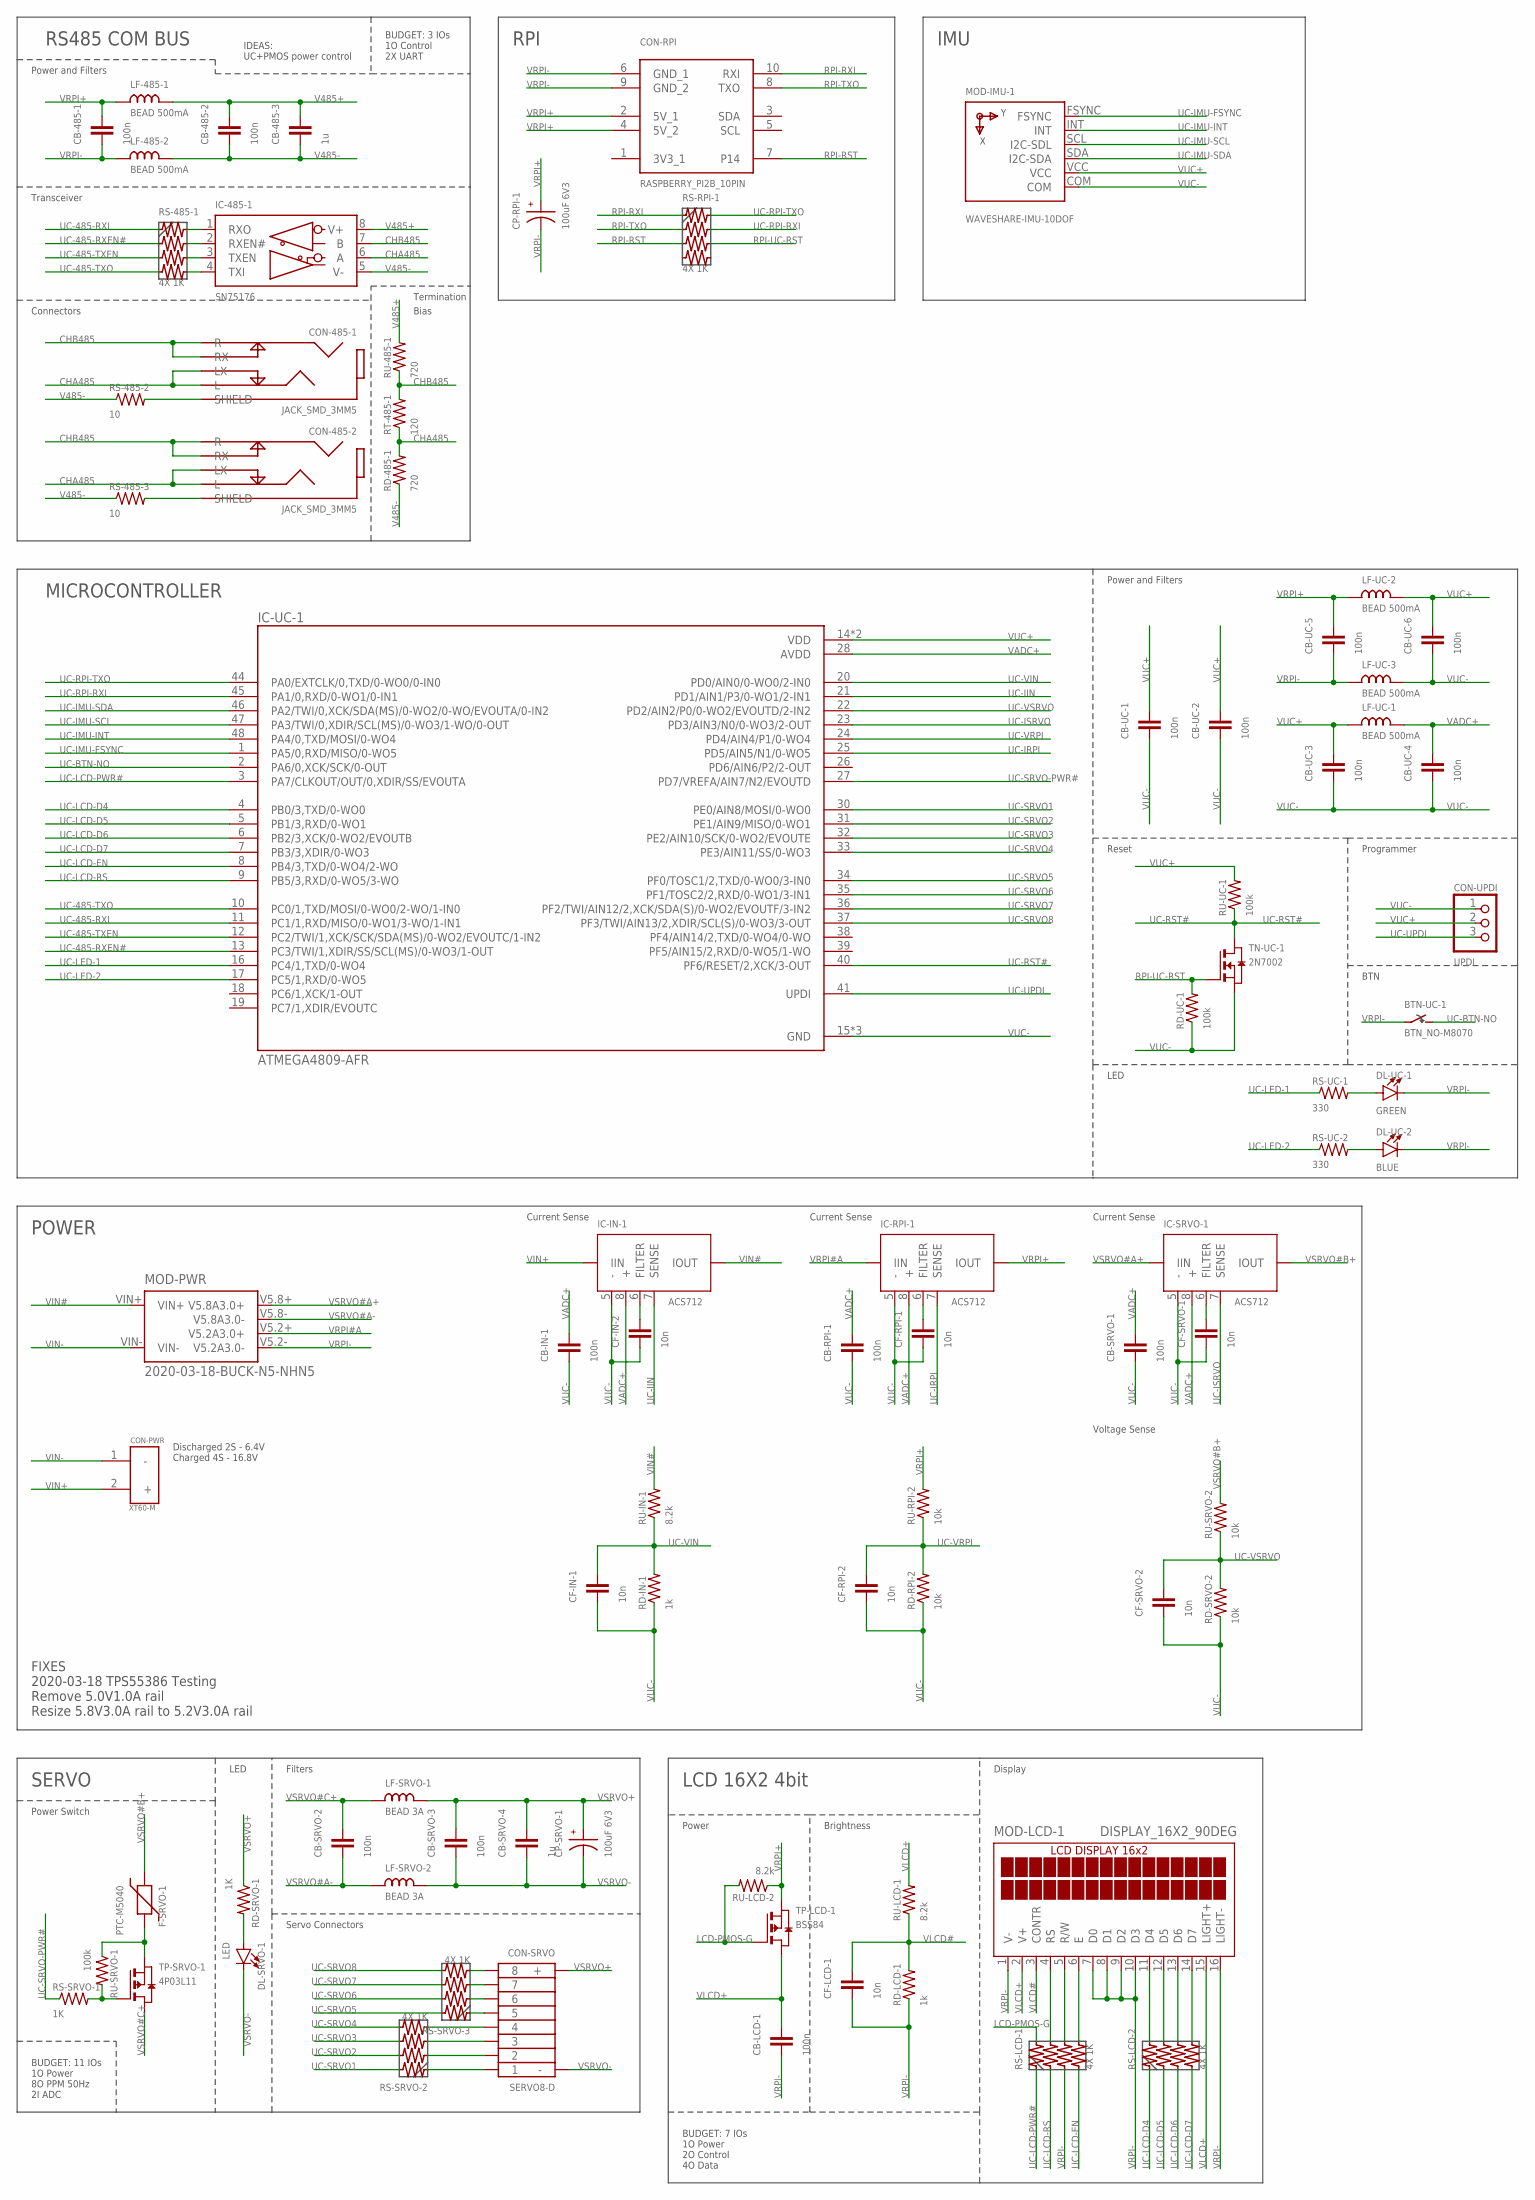
[picture p21: schematic 2021-07-02 OrangeHat.sch, <b>OrangeHat</b><p>]

Parts:
BTN-UC-1: BTN_NO-M8070; SMD_BTN_M8070
CB-485-1, CB-485-2: 100n; SMD-M2012
CB-485-3: 1u; SMD-M2012
CB-IN-1: 100n; SMD-M2012
CB-LCD-1: 100n; SMD-M2012
CB-RPI-1: 100n; SMD-M2012
CB-SRVO-1, CB-SRVO-2, CB-SRVO-3: 100n; SMD-M2012
CB-SRVO-4: 1u; SMD-M2012
CB-UC-1, CB-UC-2, CB-UC-3, CB-UC-4, CB-UC-5, CB-UC-6: 100n; SMD-M2012
CF-IN-1, CF-IN-2: 10n; SMD-M2012
CF-LCD-1: 10n; SMD-M2012
CF-RPI-1, CF-RPI-2: 10n; SMD-M2012
CF-SRVO-1, CF-SRVO-2: 10n; SMD-M2012
CON-485-1, CON-485-2: JACK_SMD_3MM5
CON-PWR: XT60-M; AMASS_XT60-M
CON-RPI: RASPBERRY_PI2B_10PIN
CON-SRVO: SERVO8-D; SERVO8#
CON-UPDI: UPDI; 1X03
CP-RPI-1: 100uF 6V3; E2,5-5
CP-SRVO-1: 100uF 6V3; E2,5-5
DL-SRVO-1: LED; SMD-M2012-POL
DL-UC-1: GREEN; SMD-M2012-POL
DL-UC-2: BLUE; SMD-M2012-POL
F-SRVO-1: PTC-M5040; SMD-M5040
IC-485-1: SN75176; DIL08
IC-IN-1: ACS712; SO8
IC-RPI-1: ACS712; SO8
IC-SRVO-1: ACS712; SO8
IC-UC-1: ATMEGA4809-AFR; QFP50P900X900X120-48N
LF-485-1, LF-485-2: BEAD 500mA; SMD-M2012
LF-SRVO-1, LF-SRVO-2: BEAD 3A; SMD-M2016
LF-UC-1, LF-UC-2, LF-UC-3: BEAD 500mA; SMD-M2012
MOD-IMU-1: WAVESHARE-IMU-10DOF
MOD-LCD-1: DISPLAY_16X2_90DEG
MOD-PWR: 2020-03-18-BUCK-N5-NHN5; 2020-03-18-BUCK-NHN5
RD-485-1: 720; TH-2MM54-V
RD-IN-1: 1k; SMD-M2012
RD-LCD-1: 1k; SMD-M2012
RD-RPI-2: 10k; SMD-M2012
RD-SRVO-1: 1K; SMD-M2012
RD-SRVO-2: 10k; SMD-M2012
RD-UC-1: 100k; SMD-M2012
RS-485-1: 4X 1K; RAC1206
RS-485-2, RS-485-3: 10; SMD-M2012
RS-LCD-1, RS-LCD-2: 4X 1K; RAC1206
RS-RPI-1: 4X 1K; RAC1206
RS-SRVO-1: 1K; SMD-M2012
RS-SRVO-2, RS-SRVO-3: 4X 1K; RAC1206
RS-UC-1, RS-UC-2: 330; SMD-M2012
RT-485-1: 120; TH-2MM54-V
RU-485-1: 720; TH-2MM54-V
RU-IN-1: 8.2k; SMD-M2012
RU-LCD-1, RU-LCD-2: 8.2k; SMD-M2012
RU-RPI-2: 10k; SMD-M2012
RU-SRVO-1: 100k; SMD-M2012
RU-SRVO-2: 10k; SMD-M2012
RU-UC-1: 100k; SMD-M2012
TN-UC-1: 2N7002; SOT23
TP-LCD-1: BSS84; SOT23
TP-SRVO-1: 4P03L11; TO252

Connections:
3V3_1: CON-RPI.1 (3V3_1)
CHA485: CON-485-1.L, CON-485-1.LX, CON-485-2.L, CON-485-2.LX, IC-485-1.6 (A), RD-485-1.2, RT-485-1.1
CHB485: CON-485-1.R, CON-485-1.RX, CON-485-2.R, CON-485-2.RX, IC-485-1.7 (B), RT-485-1.2, RU-485-1.1
LCD-PMOS-G: RS-LCD-1.1B, RU-LCD-2.2, TP-LCD-1.1 (G)
unnamed: CF-RPI-1.2, IC-RPI-1.6 (FILTER)
unnamed: CF-IN-2.2, IC-IN-1.6 (FILTER)
unnamed: MOD-LCD-1.5 (R/W), RS-LCD-1.3B
unnamed: DL-UC-1.+, RS-UC-1.2
unnamed: RS-SRVO-1.2, RU-SRVO-1.2, TP-SRVO-1.1 (G)
unnamed: F-SRVO-1.2, RU-SRVO-1.1, TP-SRVO-1.2 (S)
unnamed: MOD-LCD-1.4 (RS), RS-LCD-1.2B
unnamed: MOD-LCD-1.6 (E), RS-LCD-1.4B
unnamed: MOD-LCD-1.11 (D4), RS-LCD-2.1B
unnamed: MOD-LCD-1.12 (D5), RS-LCD-2.2B
unnamed: MOD-LCD-1.13 (D6), RS-LCD-2.3B
unnamed: MOD-LCD-1.14 (D7), RS-LCD-2.4B
unnamed: DL-UC-2.+, RS-UC-2.2
unnamed: IC-485-1.1 (RXO), RS-485-1.1B
unnamed: IC-485-1.2 (RXEN#), RS-485-1.2B
unnamed: CF-SRVO-1.2, IC-SRVO-1.6 (FILTER)
unnamed: DL-SRVO-1.+, RD-SRVO-1.2
unnamed: CON-SRVO.8, RS-SRVO-3.4A
unnamed: CON-SRVO.7, RS-SRVO-3.3A
unnamed: CON-SRVO.6, RS-SRVO-3.2A
unnamed: CON-SRVO.5, RS-SRVO-3.1A
unnamed: CON-SRVO.4, RS-SRVO-2.4A
unnamed: CON-SRVO.3, RS-SRVO-2.3A
unnamed: CON-SRVO.2, RS-SRVO-2.2A
unnamed: CON-SRVO.1, RS-SRVO-2.1A
unnamed: IC-485-1.3 (TXEN), RS-485-1.3B
unnamed: IC-485-1.4 (TXI), RS-485-1.4B
unnamed: CON-485-1.SHIELD, RS-485-2.2
unnamed: CON-485-2.SHIELD, RS-485-3.2
RPI-RST: CON-RPI.7 (P14), RS-RPI-1.3A
RPI-RXI: CON-RPI.10 (RXI), RS-RPI-1.1A
RPI-TXO: CON-RPI.8 (TXO), RS-RPI-1.2A
RPI-UC-RST: RD-UC-1.2, RS-RPI-1.3B, TN-UC-1.1 (G)
UC-485-RXEN#: IC-UC-1.13 (PC3/TWI/1,XDIR/SS/SCL(MS)/0-WO3/1-OUT), RS-485-1.2A
UC-485-RXI: IC-UC-1.11 (PC1/1,RXD/MISO/0-WO1/3-WO/1-IN1), RS-485-1.1A
UC-485-TXEN: IC-UC-1.12 (PC2/TWI/1,XCK/SCK/SDA(MS)/0-WO2/EVOUTC/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), RS-485-1.3A
UC-485-TXO: IC-UC-1.10 (PC0/1,TXD/MOSI/0-WO0/2-WO/1-IN0), RS-485-1.4A
UC-BTN-NO: BTN-UC-1.2B, BTN-UC-1.3B, IC-UC-1.2 (PA6/0,XCK/SCK/0-OUT)
UC-IIN: IC-IN-1.7 (SENSE), IC-UC-1.21 (PD1/AIN1/P3/0-WO1/2-IN1)
UC-IMU-FSYNC: IC-UC-1.1 (PA5/0,RXD/MISO/0-WO5), MOD-IMU-1.FSYNC
UC-IMU-INT: IC-UC-1.48 (PA4/0,TXD/MOSI/0-WO4), MOD-IMU-1.INT
UC-IMU-SCL: IC-UC-1.47 (PA3/TWI/0,XDIR/SCL(MS)/0-WO3/1-WO/0-OUT), MOD-IMU-1.SCL (I2C-SDL)
UC-IMU-SDA: IC-UC-1.46 (PA2/TWI/0,XCK/SDA(MS)/0-WO2/0-WO/EVOUTA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), MOD-IMU-1.SDA (I2C-SDA)
UC-IRPI: IC-RPI-1.7 (SENSE), IC-UC-1.25 (PD5/AIN5/N1/0-WO5)
UC-ISRVO: IC-SRVO-1.7 (SENSE), IC-UC-1.23 (PD3/AIN3/N0/0-WO3/2-OUT)
UC-LCD-D4: IC-UC-1.4 (PB0/3,TXD/0-WO0), RS-LCD-2.1A
UC-LCD-D5: IC-UC-1.5 (PB1/3,RXD/0-WO1), RS-LCD-2.2A
UC-LCD-D6: IC-UC-1.6 (PB2/3,XCK/0-WO2/EVOUTB), RS-LCD-2.3A
UC-LCD-D7: IC-UC-1.7 (PB3/3,XDIR/0-WO3), RS-LCD-2.4A
UC-LCD-EN: IC-UC-1.8 (PB4/3,TXD/0-WO4/2-WO), RS-LCD-1.4A
UC-LCD-PWR#: IC-UC-1.3 (PA7/CLKOUT/OUT/0,XDIR/SS/EVOUTA), RS-LCD-1.1A
UC-LCD-RS: IC-UC-1.9 (PB5/3,RXD/0-WO5/3-WO), RS-LCD-1.2A
UC-LED-1: IC-UC-1.16 (PC4/1,TXD/0-WO4), RS-UC-1.1
UC-LED-2: IC-UC-1.17 (PC5/1,RXD/0-WO5), RS-UC-2.1
UC-RPI-RXI: IC-UC-1.45 (PA1/0,RXD/0-WO1/0-IN1), RS-RPI-1.2B
UC-RPI-TXO: IC-UC-1.44 (PA0/EXTCLK/0,TXD/0-WO0/0-IN0), RS-RPI-1.1B
UC-RST#: IC-UC-1.40 (PF6/RESET/2,XCK/3-OUT), RU-UC-1.1, TN-UC-1.3 (D)
UC-SRVO1: IC-UC-1.30 (PE0/AIN8/MOSI/0-WO0), RS-SRVO-2.1B
UC-SRVO2: IC-UC-1.31 (PE1/AIN9/MISO/0-WO1), RS-SRVO-2.2B
UC-SRVO3: IC-UC-1.32 (PE2/AIN10/SCK/0-WO2/EVOUTE), RS-SRVO-2.3B
UC-SRVO4: IC-UC-1.33 (PE3/AIN11/SS/0-WO3), RS-SRVO-2.4B
UC-SRVO5: IC-UC-1.34 (PF0/TOSC1/2,TXD/0-WO0/3-IN0), RS-SRVO-3.1B
UC-SRVO6: IC-UC-1.35 (PF1/TOSC2/2,RXD/0-WO1/3-IN1), RS-SRVO-3.2B
UC-SRVO7: IC-UC-1.36 (PF2/TWI/AIN12/2,XCK/SDA(S)/0-WO2/EVOUTF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), RS-SRVO-3.3B
UC-SRVO8: IC-UC-1.37 (PF3/TWI/AIN13/2,XDIR/SCL(S)/0-WO3/3-OUT), RS-SRVO-3.4B
UC-SRVO-PWR#: IC-UC-1.27 (PD7/VREFA/AIN7/N2/EVOUTD), RS-SRVO-1.1
UC-UPDI: CON-UPDI.3, IC-UC-1.41 (UPDI)
UC-VIN: CF-IN-1.2, IC-UC-1.20 (PD0/AIN0/0-WO0/2-IN0), RD-IN-1.2, RU-IN-1.1
UC-VRPI: CF-RPI-2.2, IC-UC-1.24 (PD4/AIN4/P1/0-WO4), RD-RPI-2.2, RU-RPI-2.1
UC-VSRVO: CF-SRVO-2.2, IC-UC-1.22 (PD2/AIN2/P0/0-WO2/EVOUTD/2-IN2), RD-SRVO-2.2, RU-SRVO-2.1
V485+: CB-485-2.2, CB-485-3.2, IC-485-1.8 (V+), LF-485-1.2, RU-485-1.2
V485-: CB-485-2.1, CB-485-3.1, IC-485-1.5 (V-), LF-485-2.2, RD-485-1.1, RS-485-2.1, RS-485-3.1
VADC+: CB-IN-1.2, CB-RPI-1.2, CB-SRVO-1.2, CB-UC-4.2, IC-IN-1.8 (+), IC-RPI-1.8 (+), IC-SRVO-1.8 (+), IC-UC-1.28 (AVDD), LF-UC-1.2
VIN#: IC-IN-1.3 (IOUT), IC-IN-1.4 (IOUT), MOD-PWR.VIN+, RU-IN-1.2
VIN+: CON-PWR.2 (+), IC-IN-1.1 (IIN), IC-IN-1.2 (IIN)
VIN-: CON-PWR.1 (-), MOD-PWR.VIN-
VLCD#: CF-LCD-1.2, MOD-LCD-1.3 (CONTR), RD-LCD-1.2, RU-LCD-1.1
VLCD+: CB-LCD-1.2, MOD-LCD-1.2 (V+), MOD-LCD-1.15 (LIGHT+), RU-LCD-1.2, TP-LCD-1.3 (D)
VRPI#A: IC-RPI-1.1 (IIN), IC-RPI-1.2 (IIN), MOD-PWR.V5.2+ (V5.2A3.0+)
VRPI+: CB-485-1.2, CB-UC-5.2, CON-RPI.2 (5V_1), CON-RPI.4 (5V_2), CP-RPI-1.+, IC-RPI-1.3 (IOUT), IC-RPI-1.4 (IOUT), LF-485-1.1, LF-UC-2.1, RU-LCD-2.1, RU-RPI-2.2, TP-LCD-1.2 (S)
VRPI-: BTN-UC-1.1A, BTN-UC-1.4A, CB-485-1.1, CB-LCD-1.1, CB-UC-5.1, CF-LCD-1.1, CON-RPI.6 (GND_1), CON-RPI.9 (GND_2), CP-RPI-1.-, DL-UC-1.-, DL-UC-2.-, LF-485-2.1, LF-UC-3.1, MOD-LCD-1.1 (V-), MOD-LCD-1.7 (D0), MOD-LCD-1.8 (D1), MOD-LCD-1.9 (D2), MOD-LCD-1.10 (D3), MOD-LCD-1.16 (LIGHT-), MOD-PWR.V5.2- (V5.2A3.0-), RD-LCD-1.1, RS-LCD-1.3A
VSRVO#A+: IC-SRVO-1.1 (IIN), IC-SRVO-1.2 (IIN), MOD-PWR.V5.8+ (V5.8A3.0+)
VSRVO#A-: CB-SRVO-2.1, LF-SRVO-2.1, MOD-PWR.V5.8- (V5.8A3.0-)
VSRVO#B+: F-SRVO-1.1, IC-SRVO-1.3 (IOUT), IC-SRVO-1.4 (IOUT), RU-SRVO-2.2
VSRVO#C+: CB-SRVO-2.2, LF-SRVO-1.1, TP-SRVO-1.3 (D)
VSRVO+: CB-SRVO-3.2, CB-SRVO-4.2, CON-SRVO.1+ (+), CON-SRVO.2+ (+), CON-SRVO.3+ (+), CON-SRVO.4+ (+), CON-SRVO.5+ (+), CON-SRVO.6+ (+), CON-SRVO.7+ (+), CON-SRVO.8+ (+), CP-SRVO-1.+, LF-SRVO-1.2, RD-SRVO-1.1
VSRVO-: CB-SRVO-3.1, CB-SRVO-4.1, CON-SRVO.1- (-), CON-SRVO.2- (-), CON-SRVO.3- (-), CON-SRVO.4- (-), CON-SRVO.5- (-), CON-SRVO.6- (-), CON-SRVO.7- (-), CON-SRVO.8- (-), CP-SRVO-1.-, DL-SRVO-1.-, LF-SRVO-2.2
VUC+: CB-UC-1.2, CB-UC-2.2, CB-UC-3.2, CB-UC-6.2, CON-UPDI.2, IC-UC-1.14 (VDD), IC-UC-1.42 (VDD), LF-UC-1.1, LF-UC-2.2, MOD-IMU-1.VCC, RU-UC-1.2
VUC-: CB-IN-1.1, CB-RPI-1.1, CB-SRVO-1.1, CB-UC-1.1, CB-UC-2.1, CB-UC-3.1, CB-UC-4.1, CB-UC-6.1, CF-IN-1.1, CF-IN-2.1, CF-RPI-1.1, CF-RPI-2.1, CF-SRVO-1.1, CF-SRVO-2.1, CON-UPDI.1, IC-IN-1.5 (-), IC-RPI-1.5 (-), IC-SRVO-1.5 (-), IC-UC-1.15 (GND), IC-UC-1.29 (GND), IC-UC-1.43 (GND), LF-UC-3.2, MOD-IMU-1.COM, RD-IN-1.1, RD-RPI-2.1, RD-SRVO-2.1, RD-UC-1.1, TN-UC-1.2 (S)

Notes on the sheet:
LCD 16X2 4bit
Power
Brightness
Display
BUDGET: 7 IOs 1O Power 2O Control 4O Data
SERVO
BUDGET: 11 IOs 1O Power 8O PPM 50Hz 2I ADC
Servo Connectors
Power Switch
Filters
Current Sense
Voltage Sense
LED
RS485 COM BUS
Power and Filters
Transceiver
Connectors
Termination
Bias
BUDGET: 3 IOs 1O Control 2X UART
IDEAS: UC+PMOS power control
MICROCONTROLLER
Reset
RPI
POWER
Programmer
FIXES 2020-03-18 TPS55386 Testing Remove 5.0V1.0A rail Resize 5.8V3.0A rail to 5.2V3.0A rail
BTN
IMU
Discharged 2S - 6.4V Charged 4S - 16.8V

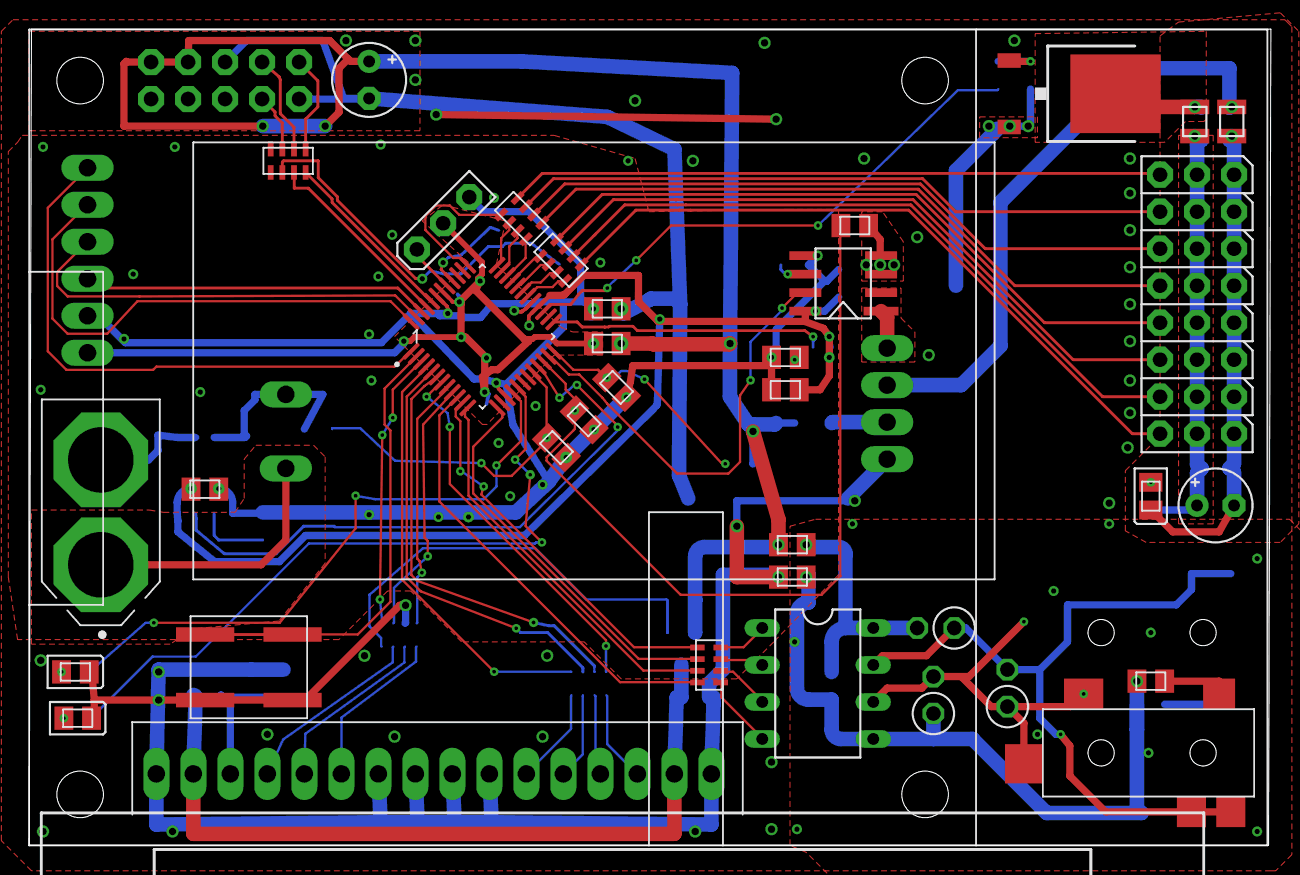
[picture p22: board 2021-07-02 OrangeHat.brd from above]

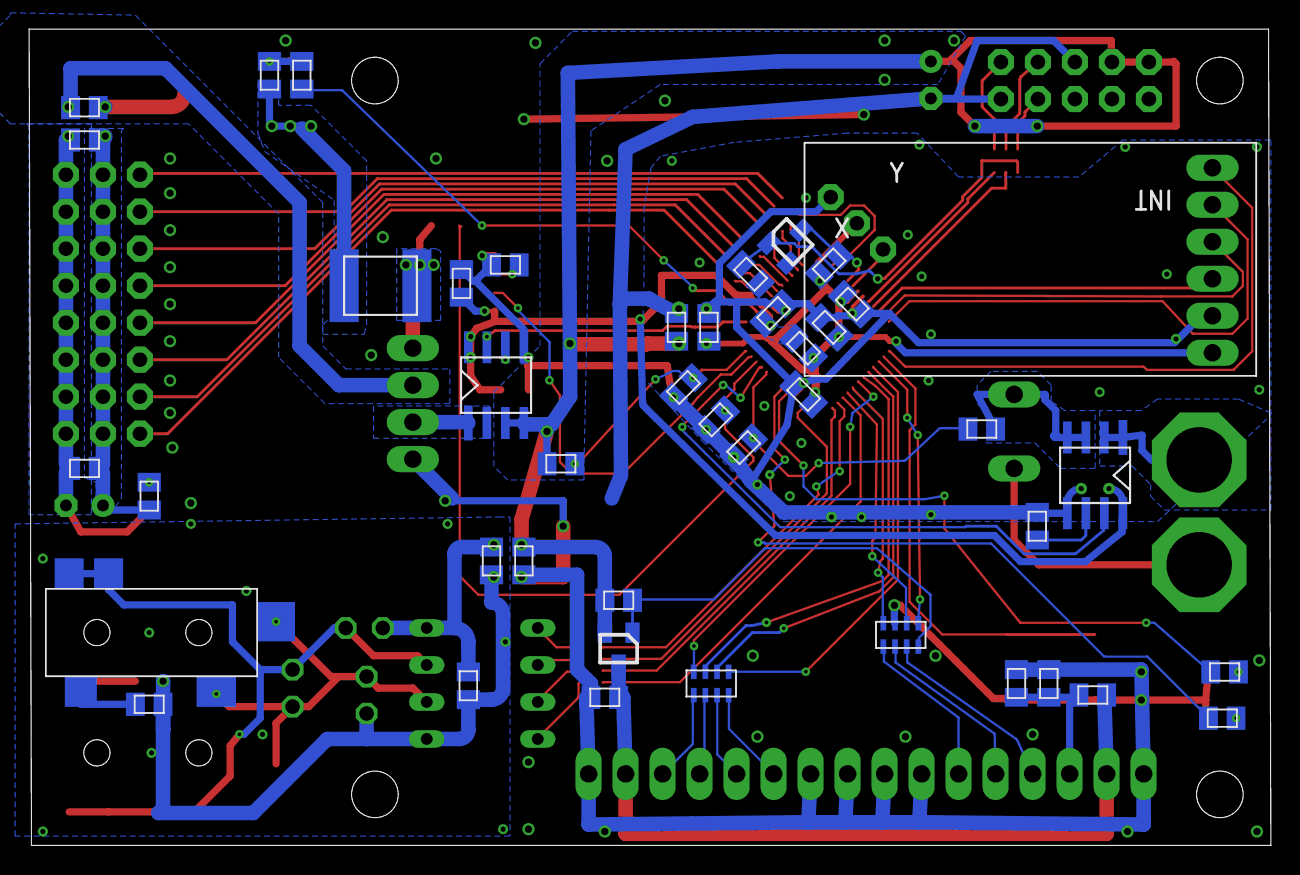
[picture p23: board 2021-07-02 OrangeHat.brd from below]

Board: 2 copper layers, 85.2 x 56.0 mm, 83 parts (43 on the bottom side), 92 nets.

Other parts of the board:
U$1: SIGNATURE_ADROBOT_SMALL
U$2: SIGNATURE_ORANGEBOT_SMALL
