OrsoEric/OrangeHat/Hardware/Board-Regulator/2020-03-18 Buck Regulator.brd

## EAGLE design Hardware/Board-Regulator/2020-03-18 Buck Regulator.brd (2021-07-03)

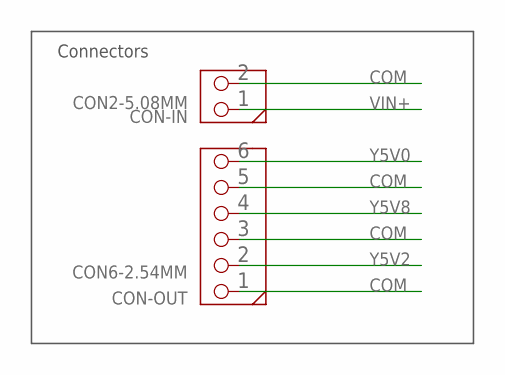
[picture p24: schematic 2020-03-18 Buck Regulator.sch, sheet 1, Connectors]

Parts:
CON-IN: CON2-5.08MM; CON2-508
CON-OUT: CON6-2.54MM; CON6

Connections:
COM: CON-IN.2, CON-OUT.1, CON-OUT.3, CON-OUT.5; also elsewhere on the board
VIN+: CON-IN.1; also elsewhere on the board
Y5V0: CON-OUT.6; also elsewhere on the board
Y5V2: CON-OUT.2; also elsewhere on the board
Y5V8: CON-OUT.4; also elsewhere on the board

Notes on the sheet:
Connectors

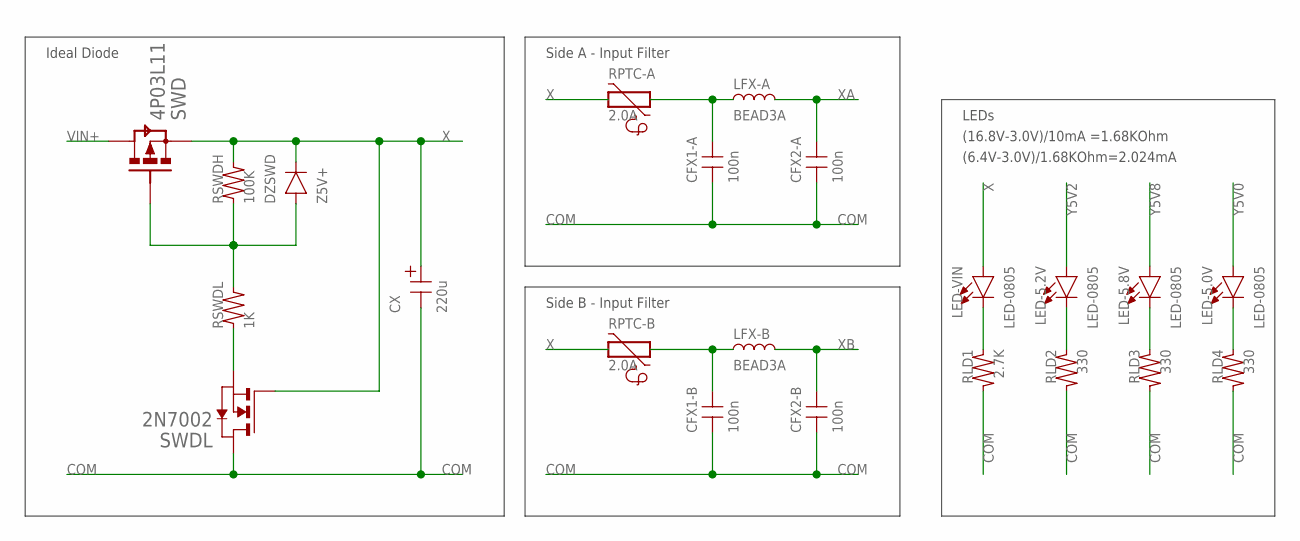
[picture p25: schematic 2020-03-18 Buck Regulator.sch, sheet 2, Protections]

Parts:
CFX1-A, CFX1-B, CFX2-A, CFX2-B: 100n; SMD0805
CX: 220u; CPOL-5MM5
DZSWD: Z5V+; SMD0805-POL
LED-5.0V, LED-5.2V, LED-5.8V: LED-0805; SMD0805-POL
LED-VIN: LED-0805; SMD0805-POL
LFX-A: BEAD3A; SMD2MM0X1MM60
LFX-B: BEAD3A; SMD2MM0X1MM60
RLD1: 2.7K; SMD0805
RLD2, RLD3, RLD4: 330; SMD0805
RPTC-A: 2.0A; M0805
RPTC-B: 2.0A; M0805
RSWDH: 100K; SMD0805
RSWDL: 1K; SMD0805
SWD: 4P03L11; TO252
SWDL: 2N7002; SOT23

Connections:
COM: CFX1-A.2, CFX1-B.2, CFX2-A.2, CFX2-B.2, CX.-, RLD1.2, RLD2.2, RLD3.2, RLD4.2, SWDL.3 (D); also elsewhere on the board
unnamed: CFX1-A.1, LFX-A.1, RPTC-A.2
unnamed: DZSWD.+, RSWDH.1, RSWDL.2, SWD.1 (G)
unnamed: RSWDL.1, SWDL.2 (S)
unnamed: LED-VIN.-, RLD1.1
unnamed: LED-5.2V.-, RLD2.1
unnamed: LED-5.8V.-, RLD3.1
unnamed: LED-5.0V.-, RLD4.1
unnamed: CFX1-B.1, LFX-B.1, RPTC-B.2
VIN+: SWD.3 (D); also elsewhere on the board
X: CX.+, DZSWD.-, LED-VIN.+, RPTC-A.1, RPTC-B.1, RSWDH.2, SWD.2 (S), SWDL.1 (G)
XA: CFX2-A.1, LFX-A.2; also elsewhere on the board
XB: CFX2-B.1, LFX-B.2; also elsewhere on the board
Y5V0: LED-5.0V.+; also elsewhere on the board
Y5V2: LED-5.2V.+; also elsewhere on the board
Y5V8: LED-5.8V.+; also elsewhere on the board

Notes on the sheet:
Ideal Diode
Side A - Input Filter
Side B - Input Filter
LEDs
(16.8V-3.0V)/10mA =1.68KOhm
(6.4V-3.0V)/1.68KOhm=2.024mA

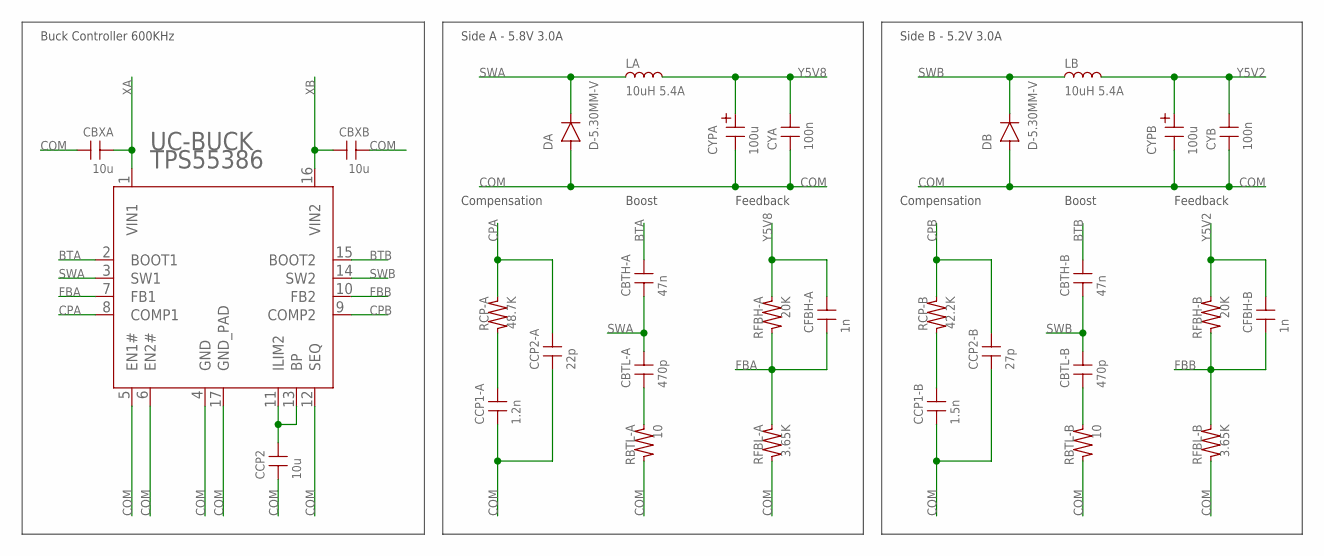
[picture p26: schematic 2020-03-18 Buck Regulator.sch, sheet 3, Buck Regulator]

Parts:
CBTH-A: 47n; SMD0805
CBTH-B: 47n; SMD0805
CBTL-A: 470p; SMD0805
CBTL-B: 470p; SMD0805
CBXA: 10u; SMD3MM2X1MM60
CBXB: 10u; SMD3MM2X1MM60
CCP1-A: 1.2n; SMD0805
CCP1-B: 1.5n; SMD0805
CCP2: 10u; SMD3MM2X1MM60
CCP2-A: 22p; SMD0805
CCP2-B: 27p; SMD0805
CFBH-A: 1n; SMD0805
CFBH-B: 1n; SMD0805
CYA: 100n; SMD0805
CYB: 100n; SMD0805
CYPA: 100u; CPOL-5MM5
CYPB: 100u; CPOL-5MM5
DA: D-5.30MM-V; THV-5MM30
DB: D-5.30MM-V; THV-5MM30
LA: 10uH 5.4A; SMD12MM8X12MM8
LB: 10uH 5.4A; SMD12MM8X12MM8
RBTL-A: 10; SMD0805
RBTL-B: 10; SMD0805
RCP-A: 48.7K; SMD0805
RCP-B: 42.2K; SMD0805
RFBH-A: 20K; SMD0805
RFBH-B: 20K; SMD0805
RFBL-A: 3.65K; SMD0805
RFBL-B: 3.65K; SMD0805
UC-BUCK: TPS55386; HTSSOP16

Connections:
BTA: CBTH-A.1, UC-BUCK.2 (BOOT1)
BTB: CBTH-B.1, UC-BUCK.15 (BOOT2)
COM: CBXA.1, CBXB.2, CCP1-A.2, CCP1-B.2, CCP2.2, CCP2-A.2, CCP2-B.2, CYA.2, CYB.2, CYPA.-, CYPB.-, DA.+, DB.+, RBTL-A.2, RBTL-B.2, RFBL-A.2, RFBL-B.2, UC-BUCK.4 (GND), UC-BUCK.5 (EN1#), UC-BUCK.6 (EN2#), UC-BUCK.12 (SEQ), UC-BUCK.17 (GND_PAD); also elsewhere on the board
CPA: CCP2-A.1, RCP-A.1, UC-BUCK.8 (COMP1)
CPB: CCP2-B.1, RCP-B.1, UC-BUCK.9 (COMP2)
FBA: CFBH-A.2, RFBH-A.2, RFBL-A.1, UC-BUCK.7 (FB1)
FBB: CFBH-B.2, RFBH-B.2, RFBL-B.1, UC-BUCK.10 (FB2)
unnamed: CBTL-A.2, RBTL-A.1
unnamed: CCP2.1, UC-BUCK.11 (ILIM2), UC-BUCK.13 (BP)
unnamed: CCP1-A.1, RCP-A.2
unnamed: CCP1-B.1, RCP-B.2
unnamed: CBTL-B.2, RBTL-B.1
SWA: CBTH-A.2, CBTL-A.1, DA.-, LA.1, UC-BUCK.3 (SW1)
SWB: CBTH-B.2, CBTL-B.1, DB.-, LB.1, UC-BUCK.14 (SW2)
XA: CBXA.2, UC-BUCK.1 (VIN1); also elsewhere on the board
XB: CBXB.1, UC-BUCK.16 (VIN2); also elsewhere on the board
Y5V2: CFBH-B.1, CYB.1, CYPB.+, LB.2, RFBH-B.1; also elsewhere on the board
Y5V8: CFBH-A.1, CYA.1, CYPA.+, LA.2, RFBH-A.1; also elsewhere on the board

Notes on the sheet:
Side A - 5.8V 3.0A
Buck Controller 600KHz
Compensation
Boost
Feedback
Side B - 5.2V 3.0A

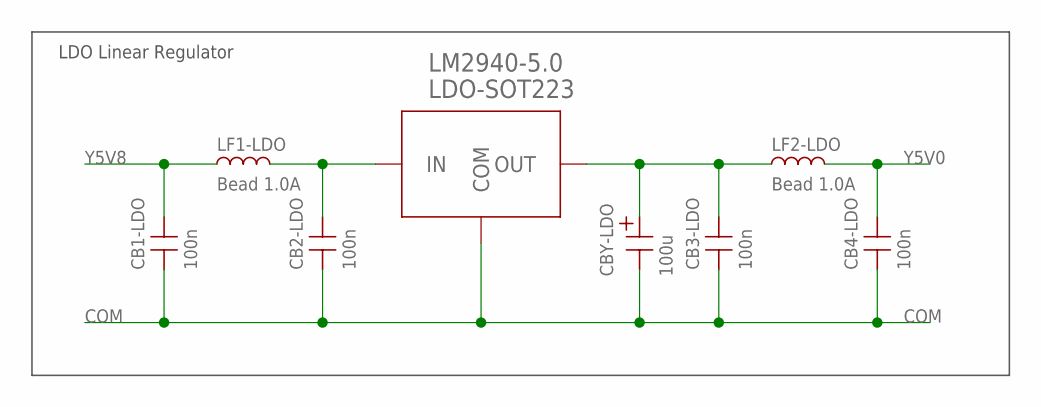
[picture p27: schematic 2020-03-18 Buck Regulator.sch, sheet 4, LDO]

Parts:
CB1-LDO, CB2-LDO, CB3-LDO, CB4-LDO: 100n; SMD0805
CBY-LDO: 100u; CPOL-5MM5
LF1-LDO, LF2-LDO: Bead 1.0A; SMD0805
LM2940-5.0: LDO-SOT223; SOT223

Connections:
COM: CB1-LDO.2, CB2-LDO.2, CB3-LDO.2, CB4-LDO.2, CBY-LDO.-, LM2940-5.0.2 (COM), LM2940-5.0.4 (COM); also elsewhere on the board
unnamed: CB3-LDO.1, CBY-LDO.+, LF2-LDO.1, LM2940-5.0.3 (OUT)
unnamed: CB2-LDO.1, LF1-LDO.2, LM2940-5.0.1 (IN)
Y5V0: CB4-LDO.1, LF2-LDO.2; also elsewhere on the board
Y5V8: CB1-LDO.1, LF1-LDO.1; also elsewhere on the board

Notes on the sheet:
LDO Linear Regulator

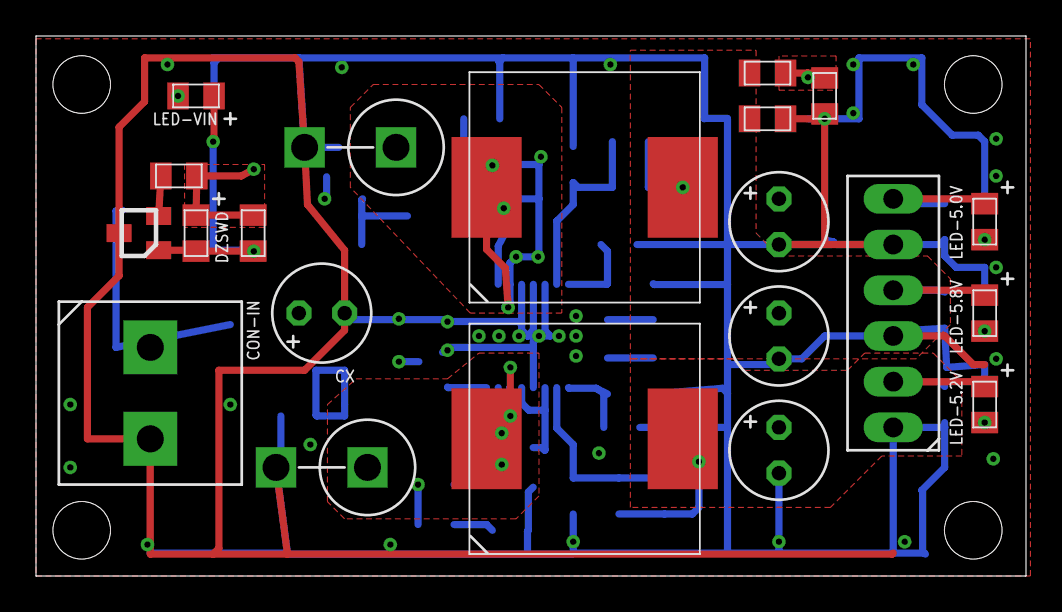
[picture p28: board 2020-03-18 Buck Regulator.brd from above]

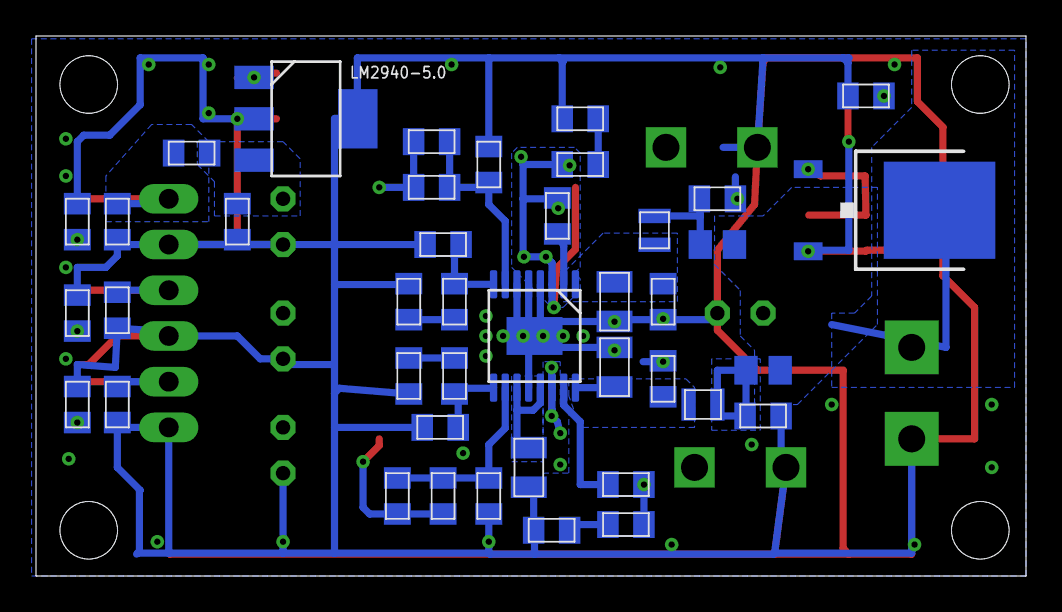
[picture p29: board 2020-03-18 Buck Regulator.brd from below]

Board: 2 copper layers, 55.0 x 30.0 mm, 64 parts (41 on the bottom side), 31 nets.

Other parts of the board:
U$1: SIGNATURE_ORANGEBOT_SMALL
U$2: SIGNATURE_ADROBOT_SMALL
