OrsoEric/OrangeHat/Firmware/main.cpp

/****************************************************************
**	OrangeBot Project
*****************************************************************
**        /
**       /
**      /
** ______ \
**         \
**          \
*****************************************************************
**	OrangeHat
*****************************************************************
**  This firmware runs on the OrangeHat and is meant to test peripherals
**
**	Compiler flags: -std=c++11 -fno-threadsafe-statics -fkeep-inline-functions
**		-Os							|
**		-std=c++11					|
**		-fno-threadsafe-statics		| disable mutex around static local variables
**		-fkeep-inline-functions		| allow use of inline methods outside of .h for PidS16
**	Compiler Symbols: F_CPU=20000000
**		-D"F_CPU=20000000"			| <util/delay.h> hardwired delay
****************************************************************/

/****************************************************************
**	DESCRIPTION
****************************************************************
**	OrangeHat test blink
****************************************************************/

/****************************************************************
**	HISTORY VERSION
****************************************************************
**		2021-08-19
**	Initial Release
**		2021-12-19
**	Import AT324 LCD16x2 Library for controller KS0066U with CDM1602K lcd display with backlight
**	Refactor the library to make use of the embedded string class
**	Refactor the library to use AT4809 IO
**	Compiles with no error
**	Power ON and OFF the display
**	Show a welcome message on the LCD on power ON: SUCCESS
**	Show a number that changes twice a second: SUCCESS
**	TODO: I learned a lot about C++ since I wrote the lcd library. Rewrite the LCD library as class.
**	SERVO PINs. Toggle power ON and OFF to test power delivery
**		2021-12-31
**	soft start encapsulated inside servo.hpp class
**		2021-01-05
**	servo driver in a working state
**	demo with generation of eight random position and speeds
****************************************************************/

/****************************************************************
**	USED PINS
****************************************************************
**
**	LEDs			|	Microcontroller
**	uc.led.green	|	uc.C4 (true = ON)
**	uc.led.blue		|	uc.C5 (true = ON)
**
**	BUTTON			|	Microcontroller
**	uc.btn.no0		|	uc.A6 (push = FALSE)
**
**	ADC
**	pwr.vin			|	uc.d0.adc0
**	pwr.iin			|	uc.d1.adc1
**	servo.vin		|	uc.d2.adc2
**	servo.iin		|	uc.d3.adc3
**	rpi.vin			|	uc.d4.adc4
**	rpi.iin			|	uc.d5.adc5
**
**	UART
**	rpi.rxi			|	uc.a0.txo
**	rpi.txo			|	uc.a1.rxi
**	rpi.p4			|	uc.rst#
**
**	DISPLAY			|	Microcontroller
**	uc.lcd.pwr#		|	uc.A7
**	uc.lcd.D4		|	uc.B0
**	uc.lcd.D5		|	uc.B1
**	uc.lcd.D6		|	uc.B2
**	uc.lcd.D7		|	uc.B3
**	uc.lcd.EN		|	uc.B4
**	uc.lcd.RS		|	uc.B4
**
**	SERVO			|	Microcontroller
**	uc.servo.pwr#	|	uc.D7
**	uc.servo.ch1	|	uc.E0
**	uc.servo.ch2	|	uc.E1
**	uc.servo.ch3	|	uc.E2
**	uc.servo.ch4	|	uc.E3
**	uc.servo.ch5	|	uc.F0
**	uc.servo.ch6	|	uc.F1
**	uc.servo.ch7	|	uc.F2
**	uc.servo.ch8	|	uc.F3
**
****************************************************************/

/****************************************************************
**	KNOWN BUGS
****************************************************************
**
****************************************************************/

/****************************************************************
**	DEFINES
****************************************************************/

#define EVER (;;)

//#define DEMO_SERVO

/****************************************************************
**	INCLUDES
****************************************************************/

//Boilerplate. Inhibit implementation when calling
#define USER_INIBITH_IMPLEMENTATION

//type definition using the bit width and sign
#include <stdint.h>
//RNG
#include <stdlib.h>
//define the ISR routune, ISR vector, and the sei() cli() function
#include <avr/interrupt.h>
//name all the register and bit
#include <avr/io.h>
//General purpose macros
#include "at_utils.h"
//AT4809 PORT macros definitions
#include "at4809_port.h"
//
#include "global.h"
//hard coded delay
#include <util/delay.h>


//Driver for 16X2LCD controller KS0066U with CDM1602K display
#include "at_lcd.h"
//Driver for the UART communication. Provides init, ISR and buffers
#include "uart.h"
//Parser for UART commands
#include "uniparser.h"

//Driver for the 16b multi channel timeout ISR servo driver
#include "servo.h"
//Driver for the ADC
#include "adc.h"

/****************************************************************
** FUNCTION PROTOTYPES
****************************************************************/

//Report an error to the application
extern bool report_error( Error_code ie_error_code );
//register all commands and associated callback functions
extern bool init_parser_commands( Orangebot::Uniparser &parser_tmp );

/****************************************************************
** GLOBAL VARIABLES
****************************************************************/

//Flags used by the ISRs
volatile Isr_flags g_isr_flags = { 0 };
//Error code of the application
volatile Error_code ge_error_code = Error_code::OK;

//Raspberry PI UART RX Parser
//Orangebot::Uniparser rpi_rx_parser;

	///----------------------------------------------------------------------
	///	ADC DRIVER
	///----------------------------------------------------------------------

//Instance of ADC class. Acquire analog quantities
User::Adc gcl_adc;

	///----------------------------------------------------------------------
	///	UART DRIVER
	///----------------------------------------------------------------------

//Class to handle UART0
User::Uart gcl_uart0;
//Parse RX data and automatically execute registered callback functions
Orangebot::Uniparser gcl_rx_parser;

extern uint8_t g_uart_timeout_cnt;

	///----------------------------------------------------------------------
	///	SERVO DRIVER
	///----------------------------------------------------------------------

//Instance of the servo controller class
OrangeBot::Servo gc_servo; 

/****************************************************************************
**  Function
**  main |
****************************************************************************/
//! @return bool |
//! @brief dummy method to copy the code
//! @details test the declaration of a lambda method
/***************************************************************************/

int main(void)
{
	//----------------------------------------------------------------
	//	VARS
	//----------------------------------------------------------------
	
	uint16_t cnt = 0;
	
	bool u1_fail;
	
	//----------------------------------------------------------------
	//	INIT
	//----------------------------------------------------------------

	//! Initialize AT4809 internal peripherals
	init();
	
		///----------------------------------------------------------------------
		///	ADC Driver
		///----------------------------------------------------------------------
	
	
	//Construct and initialize ADC class
	gcl_adc = User::Adc();
	
		///----------------------------------------------------------------------
		///	UART Driver
		///----------------------------------------------------------------------
	
	//Construct and initialize UART class
	gcl_uart0 = User::Uart();
	
	//register all commands and associated callback functions
	u1_fail = init_parser_commands( gcl_rx_parser );
	if (u1_fail == true)
	{
		report_error(Error_code::ERR_PARSER);
	}
	
		///----------------------------------------------------------------------
		///	Servo Driver
		///----------------------------------------------------------------------
	
	//Construct and initialize the servo class
	gc_servo = OrangeBot::Servo();
	//Give power to servos and starts the driver
	gc_servo.power( true );
	
	//Activate interrupts
	sei();
	
	//Initialize random number generator
	srand( 0 );
	
		///----------------------------------------------------------------------
		///	Display Driver
		///----------------------------------------------------------------------
			
	//Power the LCD display
	SET_BIT( LCD_PWR_PORT.OUT, LCD_PWR_PIN );
	_delay_ms( 500.0 );
	//Power the LCD display
	CLEAR_BIT( LCD_PWR_PORT.OUT, LCD_PWR_PIN );
	_delay_ms( 500.0 );
			
	//Initialize
	lcd_init();
			
	//Welcome message
	lcd_print_str( LCD_POS( 0, 0 ), "TX: " );
	lcd_print_str( LCD_POS( 1, 0 ), "RX: " );
	
	//----------------------------------------------------------------
	//	BODY
	//----------------------------------------------------------------

	//Main loop
	for EVER
	{
		//----------------------------------------------------------------
		//	BUTTON
		//----------------------------------------------------------------
		//	Use LED0 to mirror the state of the BTN

		//If: Fast Tick
		if (g_isr_flags.fast_tick == true)
		{
			//Reset slow tick
			g_isr_flags.fast_tick = false;
			//Take the value of the button and mirror it on LED1
			SET_BIT_VALUE( LED1_PORT.OUT, LED1_PIN, GET_BIT(BTN_PORT.IN, BTN_PIN) );
			//Use the button to power the LCD
			//SET_BIT_VALUE( SERVO_PWR_PORT.OUT, SERVO_PWR_PIN, GET_BIT(BTN_PORT.IN, BTN_PIN) );
					
			//Driver that sync the user structure with the LCD.
			//This paradigm solve lots of timing problems of the direct call version.
			//You can print a million time a second, and the driver still won't bug out
			lcd_update();
		}
		
		//----------------------------------------------------------------
		//	SLOW SYSTEM TICK
		//----------------------------------------------------------------
		//	Slow tick generated by the RTC timer, prescaled by 
		//	32KHz/32/(Prescaler::TOP_SLOW_TICK+1) = 1000ms
		//	Toggle LED1

		//If: Slow Tick
		if (g_isr_flags.slow_tick == true)
		{
			//Reset slow tick
			g_isr_flags.slow_tick = false;
			
			g_uart_timeout_cnt++;
			if (g_uart_timeout_cnt > 3)
			{
				gc_servo.set_servo(0,0,0);
				gc_servo.set_servo(1,0,0);
				
			}
			
			//----------------------------------------------------------------
			//	LED DEMO
			//----------------------------------------------------------------
			
			//Toggle LED0	
			LED0_PORT.OUTTGL = MASK(LED0_PIN);
			
			
			//----------------------------------------------------------------
			//	DISPLAY DEMO
			//----------------------------------------------------------------
		
			//Power the LCD display ON and OFF
			//LCD_PWR_PORT.OUTTGL = MASK( LCD_PWR_PIN );
			
			//Power all SERVOs ON and OFF
			//SERVO_PWR_PORT.OUTTGL = MASK( SERVO_PWR_PIN );
		
			//Counter
			//lcd_print_u16( LCD_POS(1,0), cnt );
			cnt++;

			//----------------------------------------------------------------
			//	ADC DEMO
			//----------------------------------------------------------------
			
			SET_BIT( ADC0.COMMAND, ADC_STCONV_bp );
			
			uint16_t u16_adc_res;
			bool u1_fail = gcl_adc.get_result( u16_adc_res );
			if (u1_fail == false)
			{
				lcd_print_u16( LCD_POS(0,8), u16_adc_res );
			}
			
			//----------------------------------------------------------------
			//	UART DEMO
			//----------------------------------------------------------------
			
			//Transmit a data through the driver
			//USART0.TXDATAL = 'Z';	//Bypass driver buffers
			gcl_uart0.send( '0' +cnt%10 );
			//Get the transmitted data and print them on screen
			uint16_t u16_uart0_cnt;
			u1_fail = gcl_uart0.get_counter_tx( u16_uart0_cnt ) ;
			if (u1_fail == false)
			{
				lcd_print_u16( LCD_POS(0,3), u16_uart0_cnt );
			}
			//Get the received data and print them on screen
			u1_fail = gcl_uart0.get_counter_rx( u16_uart0_cnt ) ;
			if (u1_fail == false)
			{
				lcd_print_u16( LCD_POS(1,3), u16_uart0_cnt );
			}
			
			//----------------------------------------------------------------
			//	SERVO DEMO
			//----------------------------------------------------------------
			//	feed servo channels with random position and speeds
			#ifdef DEMO_SERVO
				//CHANNEL0
				if (cnt % 4 == 0)
				{
					//Move to -100us at 200us/s
					gc_servo.set_servo( 0, -200, 1000 );
				}
				else if (cnt % 4 == 2)
				{
					gc_servo.set_servo( 0, +200 );
				}
				else
				{
					//move to +100us at 400us/s
					gc_servo.set_servo( 0, 0 );
				}
				//CHANNEL 1 to 7
				for (uint8_t u8_cnt = 1; u8_cnt < OrangeBot::Servo::Config::NUM_SERVOS; u8_cnt++)
				{
					//Generate a random position
					uint16_t u16_position = (rand() %(OrangeBot::Servo::Config::SERVO_PPM_MAX_COMMAND *2)) -OrangeBot::Servo::Config::SERVO_PPM_MAX_COMMAND;
					//Generate a random speed in increments of 50
					uint16_t u16_speed = (((rand() %8)+1) *50 );
					//Ask the driver to execute the command
					gc_servo.set_servo( u8_cnt, u16_position, u16_speed );
				}
			#endif
			
		}	//end if: Slow Tick
		
		//----------------------------------------------------------------
		//	RPI USART RX --> AT4809
		//----------------------------------------------------------------
		
		uint8_t u8_data;
		//Try to receive a data from the UART
		bool u1_ret = gcl_uart0.receive( u8_data );
		//Data has been received
		if (u1_ret == false)
		{
			gcl_rx_parser.parse( u8_data );
		}
		//No data waiting to be received
		else
		{
			//do nothing
		}
		
		
		//----------------------------------------------------------------
		//	AT4809 --> RPI USART TX
		//----------------------------------------------------------------
				
		gcl_uart0.update();
		
	}	//End: Main loop

	//----------------------------------------------------------------
	//	RETURN
	//----------------------------------------------------------------

	return 0;
}	//end: main


/***************************************************************************/
//!	@brief function
//!	report_error | Error_code |
/***************************************************************************/
//! @param ie_error_code | 
//! @return bool | false = OK | true = FAIL
//! @details
//!	report error code for the application
/***************************************************************************/

bool report_error( Error_code ie_error_code )
{
	//----------------------------------------------------------------
	//	BODY
	//----------------------------------------------------------------

	if (ge_error_code != Error_code::OK)
	{
		ge_error_code = ie_error_code;
	}

	//----------------------------------------------------------------
	//	RETURN
	//----------------------------------------------------------------
	
	return false;
}	//End function: report_error | Error_code |

/***************************************************************************/
//!	@brief function
//!	function_template
/***************************************************************************/
//! @param x |
//! @return bool | false = OK | true = FAIL
//! @details
/***************************************************************************/

void function_template( void )
{
	//----------------------------------------------------------------
	//	VARS
	//----------------------------------------------------------------

	//----------------------------------------------------------------
	//	INIT
	//----------------------------------------------------------------

	//----------------------------------------------------------------
	//	BODY
	//----------------------------------------------------------------

	//----------------------------------------------------------------
	//	RETURN
	//----------------------------------------------------------------
	
	return;
}	//End function:
