OrsoEric/OrangeHat/(commit log)

2021-07-03 Voltage Regulator Module. 5.8V3.0A 5.2V3.0A 5.0V1.0A
    [2020-03-18 Buck Regulator.brd, 2020-03-18 Buck Regulator.sch]
2021-07-03 Add files via upload
    PCB Image
2021-07-03 Update and rename readme.txt to readme.md
    Added image of board regulator
2021-07-03 Add files via upload
    Board Regulator Schematics Image
2021-07-03 Update Readme.md
    add schematics image to readme
2021-07-25 Add files via upload
    RS485 Schematics and initial placement
    [2021-07-02 OrangeHat.brd, 2021-07-02 OrangeHat.sch]
2021-07-25 Add files via upload
    Details for the RS485 bus schematics and initial placement
2021-07-25 Update readme.md
    Description for Display Mockup, schematics and initial placement
2021-07-25 Add files via upload
    LCD Display Schematics and Initial Placement
    [2021-07-02 OrangeHat.brd, 2021-07-02 OrangeHat.sch]
2021-07-25 Add files via upload
    Images of servo schematics and placement
2021-07-25 Add files via upload
    Added Servo schematics and initial placement. Adjusted/created footprints.
    [2021-07-02 OrangeHat.brd, 2021-07-02 OrangeHat.sch]
2021-07-25 Update readme.md
    Documentation for the Servo schematics and initial placement
2021-07-25 Add files via upload
    Adds LED for servo power
    Tidy up packages and keepouts
    [2021-07-02 OrangeHat.brd, 2021-07-02 OrangeHat.sch]
2021-07-28 Add files via upload
    adds media, PCB rendering images
2021-07-28 Update Readme.md
    update regulator readme
2021-08-01 Assigns microcontroller pins. Draws power planes.
    [2021-07-02 OrangeHat.brd, 2021-07-02 OrangeHat.sch]
2021-08-05 add images of two assembled regulator boards
2021-08-05 tests TPS55386 board under no load condition with stable VIN
2021-08-09 completes initial placement. iterates on routing of power lines.
    [2021-07-02 OrangeHat.brd, 2021-07-02 OrangeHat.sch]
2021-08-10 routing of power lines. complete autoroute of signals.
    [2021-07-02 OrangeHat.brd, 2021-07-02 OrangeHat.sch]
2021-08-11 completes routing. generates gerber files. validates ERC and DRC with eurocircuit
    [2021-07-02 OrangeHat.brd, 2021-07-02 OrangeHat.sch, 2021-08-11-parts.csv, 2021-08-11-values.csv]
2021-08-11 adds final production schematics, PCB and gerber images.
2021-08-11 adds image of assembled boards.
2021-12-19 OrengeHat Firmware: LED Blink. github.com/OrsoEric/OrangeHat/issues/20.
    [at4809_port.h, at_utils.h, global.h, init.cpp, int.cpp, main.cpp]
2021-12-19 Ports the KS0066U written for the AT324 to the AT4809. Show a welcome message and changing numbers on the LCD display. github.com/OrsoEric/OrangeHat/issues/21
    [at_lcd.cpp, at_lcd.h, at_utils.h, debug.cpp, debug.h, init.cpp, main.cpp]
2021-12-19 Fails to power VSRVO.C line by PA7 TP-SRVO-1 MOS. Brownout due to charge sharing. github.com/OrsoEric/OrangeHat/issues/22
    [global.h, init.cpp, main.cpp]
2021-12-25 Adds images of assembled OrangeHat and LCD firmware.
2021-12-31 moves servo soft start to servo.hpp class. tests soft start, still operational.
2022-01-03 driver correctly emits a 1.5ms pulse followed by a 20ms-1.5ms pause to SERVO0. tests that SERVO0 connected to OrangeHat now holds zero position.
    [at_lcd.cpp, at_utils.h, embedded_string.cpp, global.h, init.cpp, int.cpp, main.cpp, servo.cpp]
2022-01-04 TODO: microchip studio doesn't support hpp, boilerplate. Servo drivers now scan and emit 1.5ms pulses with 20ms period on two channels. Test: SUCCESS.
    [servo.cpp]
2022-01-04 implements command. speed limit is yet to be implemented and non zero speed results in algorithm error.
    [init.cpp, main.cpp, servo.cpp]
2022-01-04 driver operational with us position and us/s speed command. BUG: when LOCK and IDLE does not emit signals. github.com/OrsoEric/OrangeHat/issues/22
    [main.cpp, servo.cpp]
2022-01-05 extends error reporter to include line number. fixes servo IO emission when LOCK and IDLE. github.com/OrsoEric/OrangeHat/issues/22
    [main.cpp, servo.cpp]
2022-01-05 Servo driver in a working state. Demo with eight servomotors connected at once SUCCESS.
2022-01-05 Adds videos of eight servomotor demo
2022-01-06 initializes UART0 and transmit one byte per second. Checks with oscilloscope that RPI RXI pin is receiving the waveform: SUCCESS.
2022-01-06 servo class split in .h and .cpp to work around limitations of microchip c++ compiler. all warnings removed.
2022-01-06 implements uart tx counter and shows the transmitted bytes on screen.
2022-01-06 implements uart rx counter, shows count on screen and tests loopback
2022-01-07 NODE.JS test serial port application. SUCCESS. github.com/OrsoEric/OrangeHat/issues/23
    [test_serial.js]
2022-01-07 Test the previously working NODE.JS OrangeBot webserver application with the RPI and OrangeHat. github.com/OrsoEric/OrangeHat/issues/25
    [pid_gain.json]
2022-01-07 links uart and parser. rx bytes are being counted, handler for ping appears not to be executed.
2022-01-07 servo motor 0 controlled by PPM*:*:* message operational.
2022-01-07 adds message timeout to stop servo 0 and 1
2022-01-07 controls two servos attached to the OrangeHat from the RaspberryPi. https://github.com/OrsoEric/OrangeHat/issues/26
    [test_servo.js]
2022-01-07 uses PPM message to move motors in PWM mode. OrangeHat application operational.
    [pid_gain.json]
2022-01-09 implements initial release of adc driver that sample temperature once a second. github.com/OrsoEric/OrangeHat/issues/27
    [adc.cpp, adc.h, init.cpp, int.cpp, main.cpp]
